Will-McKnight-604/BLDC_Motor_Control/READ_ME.txt

THE FOLDER STRUCTURE IS DIVIDED INTO:

- PROJECTS
- RESOURCES

THE PROJECTS FOLDER CONTAINS ALL THE PROJECT RELATED FILES.
THE RESOURCE FOLDER; INCLUDES ALL THE DOCUMENTATION REGARDING YOUR COMPANY FILES, SUCH AS TEMPLATES, LIBRARIES AND SO FORTH.
