Will-McKnight-604/BLDC_Motor_Control/Resources/Templates/Documentation Templates/Technical-Specification-Template.xlsx

Sheet: CORE 1. Product Vision
CORE BLOCK 1. Understanding the Product Vision and Problem-Solving Objective
Steps | Questions | Guidance | Your answers
STEP 1. Product Purpose Clarification | Can you describe the core vision behind this product? What is the primary function or experience that it is intended to deliver? | Please provide a clear and concise statement that captures the essence of the product's intent. This should reflect the unique value proposition and the experience you envision for the user.
STEP 2. Problem Identification | What specific problem or user pain point is this product aiming to address? | Detail the challenges or gaps in the current market or user experience that your product seeks to overcome. Explain how this problem affects potential users and the difference your product will make.
STEP 3. Design Relevance | How does the intended purpose of the product align with our design principles and user needs? | Discuss how the product's purpose resonates with existing design guidelines and user requirements. Consider the relevance to the target audience and how the design will cater to their preferences and behaviors.
STEP 4. Impact Analysis | In what ways will this product change or enhance the current state of affairs or user experience? | Provide an analysis of how the product is expected to impact the user's life or the broader context it fits into. This could include potential shifts in user behavior, market trends, or technological advancements.

Sheet: CORE 2. Block Diagram
CORE BLOCK 2. Facilitating the Creation of a Block Diagram
Steps | Questions | Guidance | Your answers
STEP 1. Foundation Setting | What are the main functions that the product must perform? List them out. | Start by identifying the primary functions the product will serve. These functions will form the main blocks of your diagram, setting the foundation for the overall structure.
STEP 2. Sub-Function Exploration | Within each main function, what are the essential sub-functions or components required? | Break down each main function into its necessary sub-functions. These will become the smaller blocks within your main functional blocks, helping to detail the inner workings of the product.
STEP 3. Interconnection Mapping | How do these sub-functions interact with each other and with the main functions? | For each sub-function, identify its inputs and outputs, and determine how it connects to other parts of the system. This will help in drawing the lines and arrows that show the flow of information, energy, or materials between blocks.
STEP 4. Hierarchy Determination | Is there a hierarchy or flow that naturally forms among the blocks based on their interactions? | Determine if there is a top-down or sequential flow that should be represented in the diagram. This might indicate the process flow or the importance of certain functions within the product.
STEP 5. Refinement and Review | What adjustments can be made to simplify or clarify the diagram? Are there redundant or missing elements? | Continuously refine the diagram by removing unnecessary complexity and ensuring all critical elements are represented. Review the diagram with stakeholders to validate its accuracy and comprehensibility.
STEP 6. Tool Selection for Digitalization | Which software or online tool will you use to create the digital version of this block diagram? | Choose a digital tool like draw.io, Lucidchart, or Microsoft Visio for creating a cleaner, more shareable version of your block diagram. Consider ease of use and collaboration features in your selection.
BLOCK DIAGRAM

Sheet: CORE 3. Design Requirement
CORE BLOCK 3. Prerequisite Design Requirements
Category | Requirement | Details | Examples/Options
Environmental Conditions | Operational Temperature Range | Define the range of temperatures in which the product must operate reliably. | 0 to 50°C (Consider wider ranges for extreme environments)
 | Humidity Tolerance | Specify the range of relative humidity levels the product can withstand during operation. | 5-95% non-condensing RH (Adjust for tropical or arid climates as needed)
 | Vibration Resistance | Detail the expected vibration levels the product should withstand, including frequency and amplitude. | Compliant with ISO 16750-3 for transportation and mounted operations on vehicles
 | Shock Resistance | Outline the levels and types of shock the product should resist without malfunction. | Meets MIL-STD-810G Method 516.6 for shock resistance during transportation or when mounted on machinery
 | Impact Durability | Determine if the product is likely to be subject to impacts and the level of protection required. | N/A (Specify if needed, e.g., drop-resistant to 1 meter)
 | Installation Setting | Define the typical environment for installation, whether indoors, outdoors, or variable. | Primarily indoor with potential for outdoor use under shelter
 | Mounting Considerations | Specify the mounting options and requirements based on the installation environment. | Versatile mounting: capable of tabletop, DIN rail, wall, and pole mounting options
 | Exposure to Corrosives | Assess the likelihood of corrosive substances in the environment and required protections. | No exposure anticipated (Consider corrosion-resistant materials if yes)
 | Marine Environment Exposure | Evaluate the need for marine-grade materials and protections if used near the sea. | Not required (Marine-grade protections for coastal installations if yes)
 | Weatherproofing Needs | Identify the need for weatherproofing measures based on outdoor exposure. | Not necessary (Weatherproofing required for outdoor applications if yes)
Compliance & Certification | CE / FCC Certification | Confirm the need for international regulatory compliance. | Required for sale in the EU and USA
 | UL Listing | Determine if UL safety certification is needed for the target market. | Not needed (Specify if necessary for consumer electronics or specific industries)
 | Environmental Standard Compliance | Verify if standardized environmental testing is needed for temperature, humidity, vibration, and shock. | Compliance with IEC 60068-2 standards
 | Electrical Safety Standards | Identify the relevant electrical safety standards applicable to the product. | Not required (Specify standards like IEC 60950 if applicable)
 | Hazard Safety | Consider if the product needs to be flame retardant, explosion-proof, or have other hazard mitigations. | Not applicable (Specify UL 94 for flame retardancy or ATEX for explosion-proof environments if applicable)
 | Ingress Protection (IP) Rating | Choose the appropriate IP rating to protect against solid objects and liquids. | IP65 (Consider higher IP ratings for harsh environments)
Costing & Budget | Target BOM Cost | Establish a budget for the Bill of Materials, considering all components and manufacturing processes. | 300 CHF for the electronics board (Consider additional costs for high-durability materials or complex components)
Production Volume & Availability | Expected Production Volume | Project the manufacturing volumes to determine economies of scale and component sourcing strategies. | 100 units monthly (Adjust based on market analysis and capacity)
 | Long-Term Availability | Plan for the duration of product availability and manufacturing based on industry standards and market demand. | 3 - 4 years (Extend this for industries with longer product lifecycles)
Warranty & Reliability | Warranty Parameters | Define the warranty period and terms based on product reliability and market expectations. | 2-year full replacement warranty, 1-year warranty on manufacturing defects (Consider extended warranties for premium lines)

Sheet: CORE 4. Main Features
CORE BLOCK 4. Main Technical Specifications
Specification Category | Details | Requirement Status | Notes/Instruction to Team Member
Hardware Features | Include WiFi for wireless connectivity | Must have | Detail WiFi standards and specifications required
 | A display that is legible from at least 5 feet away | Good to have | Describe preferred display size and resolution
 | User-friendly interface with a 4×4 keypad for configuration | Must have | Provide examples of similar interfaces for reference
 | LED indicators for power status and GPRS connectivity | Must have | Specify LED colors and positions
 | Serial communication via one RS232 and two RS485 interfaces | Must have | Detail any specific protocol or pinout requirements
 | Four digital inputs that are compatible with 24V signals | Must have | Confirm electrical specifications and safety requirements
 | Two relay outputs for controlling external devices | Good to have | Define the current and voltage rating for the relays
 | Device should operate on a 5V DC power input | Must have | Ensure compatibility with standard power supplies
 | Indicative LEDs on the power supply | Good to have | Specify desired indication signals (e.g., power, status)
 | Power efficiency with no more than 5W at peak and 2W typically | Must have | Provide calculations or benchmarks for power usage
Hardware Protections | Implement overvoltage, reverse voltage, and overcurrent protection for the power supply | Yes | Outline necessary certifications or standards
 | For RS232: Include ESD protection; assess need for isolation and surge protection | No (Isolation 4KV), Yes (ESD), No (Surge 4KV) | Justify the decision for inclusion or exclusion
 | For RS485: Ensure isolation and protect against ESD and power surges | Yes | Document the isolation level and surge protection details
Firmware Specifications | Determine if PC-based configuration software is necessary, and identify the supporting operating systems | To be determined | Draft potential user scenarios and compatibility tests
 | Evaluate the need for a mobile application and specify which mobile operating systems it should support | To be determined | Propose a list of core functionalities for the app
 | Outline the firmware's code structure and flow | To be determined | Create a preliminary flow chart for firmware logic
Field Upgradable Firmware | Decide on the wireless and wired connectivity options to be used for firmware upgrades | To be determined | Suggest the most reliable and cost-effective methods
 | Develop a strategy to make firmware upgrades easy for support and field staff | To be determined | Brainstorm with the support team for practical solutions
 | Establish a fail-safe mechanism for firmware upgrades in case of power interruptions | To be determined | Research best practices and existing technologies
PC or Mobile Software | Assess the necessity for PC-based configuration software, the operating systems it will support, and installation methods | To be determined | Propose a clear, user-friendly installation process
 | Determine the mobile application requirements and supported mobile operating systems | To be determined | List key features and design a basic user interface
User Experience Requirements | List features that will enhance the user experience, especially for minimal/no touch scenarios in sensitive environments | To be determined | Consult with UX experts to identify user-centric features
Enclosure Specifications | Visualize and sketch the product design considering the number of PCBs and their interconnects | To be determined | Draft initial sketches and discuss with the design team
 | Select materials, estimate the target cost, and consider ease of manufacturing, repair, and user experience | To be determined | Provide a cost-benefit analysis of material choices
 | Create 3D models to ensure all components fit and evaluate the design for environmental, compliance, and thermal management needs | To be determined | Use CAD software for accurate modeling and simulations

Sheet: CORE 5. Productions
CORE BLOCK 5. Production
Manufacturing Considerations (DFM) | Validation & Production Testing
Material Selection: Opt for materials with ready availability to prevent supply chain issues. | Test Accessibility: Design to provide clear access to all test points and interfaces.
Component Sourcing: Favor standard components to simplify procurement and reduce costs. | Firmware Support: Include firmware features that enable efficient testing and diagnostics.
Assembly Process: Design assemblies for straightforward automation to reduce labor costs. | Automation Compatibility: Ensure design is suitable for automated test equipment.
Serviceability: Ensure the design allows for easy post-production service and maintenance. | Testing Efficiency: Design for quick test setup and execution with comprehensive coverage.
Cost-Effectiveness: Maintain a balance between quality and cost-efficiency. | Volume Production Testing: Prioritize testing time reduction in high-volume production without quality compromise.
Regulatory Compliance: Adhere to industry standards and certifications to avoid delays.
This table structures the key points of manufacturing and testing considerations in a clear and concise manner, suitable for team members to understand and act upon.

Sheet: CORE 6. Failure Management
CORE BLOCK 6. Field Failure Management
Product Return and Repair Strategy | - How can product design be optimized for durability to reduce the likelihood of failures?
 | - What efficient and customer-friendly return and repair policies can be implemented?
 | - How will the design accommodate easy troubleshooting and repairs to maintain brand reputation?
 | - What are the cost-benefit implications of establishing local versus centralized service centers?
 | - How can turnaround times for repairs be minimized to enhance customer satisfaction?
Repairability Decision | - How will the choice between repairability and replaceability influence the product's lifecycle and environmental impact?
 | - What strategies can be implemented to ensure that repair processes are cost-effective and logistically feasible?
 | - How will the components' selection and assembly method affect the ease of disassembly and repair?
 | - In what ways can the product design facilitate end-of-life recycling or refurbishment?

Sheet: CORE 7. Documentation & Support
CORE BLOCK 7. Documentation & Support
Section | Questions
Documentation Creation | - What are the key features and specifications to highlight in the datasheet?
 | - What formats (manual, video) will be most effective for user documentation?
 | - How can documentation be structured to assist customers through different stages of the product lifecycle?
 | - What are the common issues to address in the FAQs or troubleshooting guide to minimize support requests?
Support Infrastructure | - What support channels (email, phone, ticket, forum) will be available to customers?
 | - What standard Service Level Agreements (SLAs) will be established to manage customer expectations?
 | - How will support requests be systematically reviewed to drive product, documentation, and support improvements?
 | - Will there be an online form or system for Return Merchandise Authorization (RMA) and how will it function?
