Will-McKnight-604/BLDC_Motor_Control/Projects/Fresu/BLDC Motor Controller/Design/rev01/rev01_1/BLDC_Motor Controller/SMT PACKAGE/BOM_REV01_1.xlsx

Designator | Footprint | Quantity | Manufacturer Part Number | JLCPCB Part Number | Comment | Supplier 1 | Supplier 2 | Supplier 3 | Price Total | Substitute 1 | Substitute 2
C10, C11, C14, C17, C19, C21, C22, C54, C55, C56, C57, C8, C9 | 0603 (Imperial) | 16 | CC0603KRX7R6BB104 | C519438 | 100nF 0603 10V ±10% | LCSC (https://www.lcsc.com/product-detail/Multilayer-Ceramic-Capacitors-MLCC-SMD-SMT_YAGEO-CC0603KRX7R6BB104_C519438.html)
C12, C13 | 0603 (Imperial) | 2 | 06035A100KAT2A | C597129 | 10pF 0603 50V ±10% | LCSC (https://www.lcsc.com/product-detail/Multilayer-Ceramic-Capacitors-MLCC-SMD-SMT_Kyocera-AVX-06035A100KAT2A_C597129.html)
C16, C18, C23, C24, C26, C27, C30, C49 | 0603 (Imperial) | 8 | CL10A225KQ8NNNC | C71000 | 2.2uF 0603 6.3V ±10% | LCSC (https://www.lcsc.com/product-detail/Multilayer-Ceramic-Capacitors-MLCC-SMD-SMT_Samsung-Electro-Mechanics-CL10A225KQ8NNNC_C71000.html)
C20, C3, C4, C5, C6 | 0603 (Imperial) | 5 | CL10A105KP8NNNC | C26413 | 1uF 0603 10V ±10% | LCSC (https://www.lcsc.com/product-detail/Multilayer-Ceramic-Capacitors-MLCC-SMD-SMT_Samsung-Electro-Mechanics-CL10A105KP8NNNC_C26413.html)
C25 | 0603 (Imperial) | 1 | CC0603KRX7R9BB103 | C100042 | 10nF 0603 50V ±10% | LCSC (https://www.lcsc.com/product-detail/Multilayer-Ceramic-Capacitors-MLCC-SMD-SMT_YAGEO-CC0603KRX7R9BB103_C100042.html)
C28 | 0603 (Imperial) | 1 | CC0603KRX7R9BB121 | C107072 | 120pF 0603 50V ±10% | LCSC (https://www.lcsc.com/product-detail/Multilayer-Ceramic-Capacitors-MLCC-SMD-SMT_YAGEO-CC0603KRX7R9BB121_C107072.html)
C29 | 0603 (Imperial) | 1 | CC0603KRX7R0BB223 | C313105 | 22nF 0603 100V ±10% | LCSC (https://www.lcsc.com/product-detail/Multilayer-Ceramic-Capacitors-MLCC-SMD-SMT_YAGEO-CC0603KRX7R0BB223_C313105.html)
C31, C32, C34, C36, C37, C38, C40, C41, C44,C35, C39, C43, C2,C33 | 0603 (Imperial) | 10 | CL10B104KC8NNNC | C15725 | 100nF 0603 100V ±10% | LCSC (https://www.lcsc.com/product-detail/Multilayer-Ceramic-Capacitors-MLCC-SMD-SMT_Samsung-Electro-Mechanics-CL10B104KC8NNNC_C15725.html)
C45, C46 | 0603 (Imperial) | 2 | CC0603KRX7R9BB222 | C107082 | 2.2nF 50V ±10% 0603 | LCSC (https://www.lcsc.com/product-detail/Multilayer-Ceramic-Capacitors-MLCC-SMD-SMT_YAGEO-CC0603KRX7R9BB222_C107082.html)
C47, C48 | 0603 (Imperial) | 2 | CC0603JRNPO9BN510 | C107051 | 51pF 50V ±5% 0603 | LCSC (https://www.lcsc.com/product-detail/Multilayer-Ceramic-Capacitors-MLCC-SMD-SMT_YAGEO-CC0603JRNPO9BN510_C107051.html)
C50, C51, C52, C53 | 0603 (Imperial) | 4 | 0603B472K500NT | C53987 | 4.7nF 50V ±10% 0603 | LCSC (https://www.lcsc.com/product-detail/Multilayer-Ceramic-Capacitors-MLCC-SMD-SMT_FH-Guangdong-Fenghua-Advanced-Tech-0603B472K500NT_C53987.html)
C7 | 0603 (Imperial) | 1 | CL10A106MP8NNNC | C85713 | 10uF 0603 10V ±10% | LCSC (https://www.lcsc.com/product-detail/Multilayer-Ceramic-Capacitors-MLCC-SMD-SMT_Samsung-Electro-Mechanics-CL10A106MP8NNNC_C85713.html)
FB1 | 0603 (Imperial) | 1 | BLM18PG121SN1D | C14709 | 120 OHM @100MHz 0603 Ferrite Beads | LCSC (https://www.lcsc.com/product-detail/Ferrite-Beads_Murata-Electronics-BLM18PG121SN1D_C14709.html)
R1, R18, R20, R22, R28, R3, R32, R37 | 0603 (Imperial) | 8 | 0603WAF3902T5E | C23153 | 39k OHM 0603 RES ±1% | LCSC (https://www.lcsc.com/product-detail/Chip-Resistor-Surface-Mount_UNI-ROYAL-Uniroyal-Elec-0603WAF3902T5E_C23153.html)
R10, R11, R19, R2, R21, R23, R43, R44, R45 | 0603 (Imperial) | 9 | 0603WAF2201T5E | C4190 | 2.2k OHM 0603 RES ±1% | LCSC (https://www.lcsc.com/product-detail/Chip-Resistor-Surface-Mount_UNI-ROYAL-Uniroyal-Elec-0603WAF2201T5E_C4190.html)
R12 | 0603 (Imperial) | 1 | 0603WAF1602T5E | C4210 | 16k OHM 0603 RES ±1% | LCSC (https://www.lcsc.com/product-detail/Chip-Resistor-Surface-Mount_UNI-ROYAL-Uniroyal-Elec-0603WAF1602T5E_C4210.html)
R13, R42, R46, R47, R48, R49 | 0603 (Imperial) | 7 | 0603WAF1002T5E | C25804 | 10k OHM 0603 RES ±1% | LCSC (https://www.lcsc.com/product-detail/Chip-Resistor-Surface-Mount_UNI-ROYAL-Uniroyal-Elec-0603WAF1002T5E_C25804.html)
R14 | 0603 (Imperial) | 1 | FRC0603F2053TS | C5126104 | 205k OHM 0603 RES ±1% | LCSC (https://www.lcsc.com/product-detail/Chip-Resistor-Surface-Mount_FOJAN-FRC0603F2053TS_C5126104.html)
R15 | 0603 (Imperial) | 1 | 0603WAF1004T5E | C22935 | 1M OHM 0603 RES ±1% | LCSC (https://www.lcsc.com/product-detail/Chip-Resistor-Surface-Mount_UNI-ROYAL-Uniroyal-Elec-0603WAF1004T5E_C22935.html)
R16 | 0603 (Imperial) | 1 | 0603WAF1802T5E | C25810 | 18k OHM 0603 RES ±1% | LCSC (https://www.lcsc.com/product-detail/Chip-Resistor-Surface-Mount_UNI-ROYAL-Uniroyal-Elec-0603WAF1802T5E_C25810.html)
R17 | 0603 (Imperial) | 1 | 0603WAF3301T5E | C22978 | 3.3k OHM 0603 RES ±1% | LCSC (https://www.lcsc.com/product-detail/Chip-Resistor-Surface-Mount_UNI-ROYAL-Uniroyal-Elec-0603WAF3301T5E_C22978.html)
R24, R25, R30, R31, R33, R34 | 0603 (Imperial) | 6 | 0603WAF470KT5E | C23164 | 4.7 OHM 0603 RES ±1% | LCSC (https://www.lcsc.com/product-detail/Chip-Resistor-Surface-Mount_UNI-ROYAL-Uniroyal-Elec-0603WAF470KT5E_C23164.html)
R26, R27, R35, R36, R9 | 0603 (Imperial) | 5 | 0603WAF1000T5E | C22775 | 100 OHM 0603 RES ±1% | LCSC (https://www.lcsc.com/product-detail/Chip-Resistor-Surface-Mount_UNI-ROYAL-Uniroyal-Elec-0603WAF1000T5E_C22775.html)
R39 | 0603 (Imperial) | 1 | 0603WAF1200T5E | C22787 | 120 OHM 0603 RES ±1% | LCSC (https://www.lcsc.com/product-detail/Chip-Resistor-Surface-Mount_UNI-ROYAL-Uniroyal-Elec-0603WAF1200T5E_C22787.html)
R4, R62, R7, R8 | 0603 (Imperial) | 4 | 0603WAF1001T5E | C21190 | 1k OHM 0603 RES ±1% | LCSC (https://www.lcsc.com/product-detail/Chip-Resistor-Surface-Mount_UNI-ROYAL-Uniroyal-Elec-0603WAF1001T5E_C21190.html)
R40, R41 | 0603 (Imperial) | 2 | 0603WAF100JT5E | C22859 | 10 OHM 0603 RES ±1% | LCSC (https://www.lcsc.com/product-detail/Chip-Resistor-Surface-Mount_UNI-ROYAL-Uniroyal-Elec-0603WAF100JT5E_C22859.html)
R5, R50, R51, R52, R53, R54, R55, R6, R60, R61 | 0603 (Imperial) | 10 | 0603WAF0000T5E | C21189 | 0 OHM 0603 RES ±1% | LCSC (https://www.lcsc.com/product-detail/Chip-Resistor-Surface-Mount_UNI-ROYAL-Uniroyal-Elec-0603WAF0000T5E_C21189.html)
R56, R57 | 0603 (Imperial) | 2 | 0603WAF5101T5E | C23186 | 5.1k OHM 0603 RES ±1% | LCSC (https://www.lcsc.com/product-detail/Chip-Resistor-Surface-Mount_UNI-ROYAL-Uniroyal-Elec-0603WAF5101T5E_C23186.html)
R58, R59 | 0603 (Imperial) | 2 | 0603WAF220JT5E | C23345 | 22 OHM 0603 RES ±1% | LCSC (https://www.lcsc.com/product-detail/Chip-Resistor-Surface-Mount_UNI-ROYAL-Uniroyal-Elec-0603WAF220JT5E_C23345.html)
TH1 | 0603 (Imperial) | 1 | NCP18XH103F03RB | C13564 | 10k OHM 0603 NTC Thermistors | LCSC (https://www.lcsc.com/product-detail/NTC-Thermistors_Murata-Electronics-NCP18XH103F03RB_C13564.html)
D10 | 1206 (Imperial) | 1 | 15-21/R6C-FQ1R1B/2T | C93133 | Red 1206 Light Emitting Diodes | LCSC (https://www.lcsc.com/product-detail/Light-Emitting-Diodes-LED_Everlight-Elec-15-21-R6C-FQ1R1B-2T_C93133.html)
D15, D2, D4, D9 | 1206 (Imperial) | 4 | 15-21/GHC-XS1T1/2T | C131257 | Emerald 1206 Light Emitting Diodes | LCSC (https://www.lcsc.com/product-detail/Light-Emitting-Diodes-LED_Everlight-Elec-15-21-GHC-XS1T1-2T_C131257.html)
C42, C59, C60 | 1210 (Imperial) | 3 | EMK325BJ106KN-T | C92769 | 10uF 1206 16V ±10% | LCSC (https://www.lcsc.com/product-detail/Multilayer-Ceramic-Capacitors-MLCC-SMD-SMT_Taiyo-Yuden-EMK325BJ106KN-T_C92769.html)
J2 | CONN-SMD_8P-P2.50_HX25003-8AWB | 1 | HX25003-8AWB | C442367 | Conn_01x08 | LCSC (https://www.lcsc.com/product-detail/Wire-To-Board-Wire-To-Wire-Connector_HX-Zhejiang-Yueqing-Hongxing-Elec-HX25003-8AWB_C442367.html)
J8 | CONN-SMD_S4B-XH-SM4-TB-LF-SN | 1 | S4B-XH-SM4-TB(LF)(SN) | C161861 | Conn_01x04 | LCSC (https://www.lcsc.com/product-detail/Wire-To-Board-Wire-To-Wire-Connector_JST-S4B-XH-SM4-TB-LF-SN_C161861.html)
J3, J9 | CONN-SMD_S6B-XH-SM4-TB-LF-SN | 2 | C2905028 | C2905028 | 1x6P XH 1 2.5mm Male pin 6 | LCSC (https://www.lcsc.com/product-detail/Wire-To-Board-Wire-To-Wire-Connector_DEALON-XH-6PWB_C2905028.html)
U5 | CONN-SMD_XH-2PWBPZ | 1 | XH-2PWBPZ | C2687444 | XH-2PWBPZ | LCSC (https://www.lcsc.com/product-detail/Wire-To-Board-Wire-To-Wire-Connector_BOOMELE-Boom-Precision-Elec-XH-2PWBPZ_C2687444.html)
J4 | CONN-SMD_XH-3AWB | 1 | C141812 | C141812 | Conn_01x03 | LCSC (https://www.lcsc.com/product-detail/Wire-To-Board-Wire-To-Wire-Connector_BOOMELE-Boom-Precision-Elec-C141812_C141812.html)
J1 | CONN-TH_XT60PW-M | 1 | XT60PW-M | C98732 | XT60PW-M | TME (https://www.tme.eu/ch/details/xt60pw-f/dc-steckverbinder/amass/?brutto=1&currency=EUR&gad_source=1)
Y1 | CRYSTAL-SMD_L5.0-W3.2 | 1 | X50328MSB2GI | C115962 | 8MHz Crystal | LCSC (https://www.lcsc.com/product-detail/Crystals_YXC-X50328MSB2GI_C115962.html)
D11, D13, D3, D6, D8 | D_SOD-323 | 5 | LRB551V-30T1G | C62119 | BAT60A | LCSC (https://www.lcsc.com/product-detail/Schottky-Barrier-Diodes-SBD_LRC-LRB551V-30T1G_C62119.html)
D5 | D_SOD-323 | 1 | PESD3V3U1UA,115 | C403915 | PESD3V3U1UA,115 | LCSC (https://www.lcsc.com/product-detail/Electrostatic-and-Surge-Protection-TVS-ESD_Nexperia-PESD3V3U1UA-115_C403915.html)
D7 | D_SOD-323 | 1 | PTVSHC3D15VUH | C312234 | SD05-7 | LCSC (https://www.lcsc.com/product-detail/Electrostatic-and-Surge-Protection-TVS-ESD_Shanghai-Prisemi-Elec-PTVSHC3D15VUH_C312234.html)
FL1 | FILTER-SMD_4P-L9.2-W6.0-P2.54-TL | 1 | 744227S | C2651119 | CMC 51UH 1A 2LN 5.5K OHM SMD | Digikey (https://www.digikey.com/en/products/detail/w%C3%BCrth-elektronik/744227S/1638886)
U3 | HTSSOP-56-1EP_6.1x14mm_P0.5mm_EP3.61x6.35mm | 1 | DRV8302DCA | C84672 | DRV8302DCA | LCSC (https://www.lcsc.com/product-detail/Motor-Driver-ICs_Texas-Instruments-DRV8302DCA_C84672.html)
L1 | IND-SMD_L7.8-W7.8_SDR0805 | 1 | SDR0805-220ML | C139488 | 22uH FIXED IND 1.5A 110 MOHM SMD | LCSC (https://www.lcsc.com/product-detail/Power-Inductors_BOURNS-SDR0805-220ML_C139488.html)
U2 | LQFP-64_10x10mm_P0.5mm | 1 | STM32F405RGT6 | C15742 | STM32F405RGTx | LCSC (https://www.lcsc.com/product-detail/Microcontroller-Units-MCUs-MPUs-SOCs_STMicroelectronics-STM32F405RGT6_C15742.html)
Printed Circuit Board | PCB | 1 | PCB_DF_ESC_rev01_1 |  | Bare Printed Circuit Board | JLCPC (https://jlcpcb.com/) | PCBWAY (https://www.pcbway.com/) |  | $1.48
C1, C58 | Plugin, Radial D16xL25mm | 2 | LKMI2501K821MF | C443097 | 820uF 80V 32m Ohm@100kHz ±20% | LCSC (https://www.lcsc.com/product-detail/Aluminum-Electrolytic-Capacitors-Leaded_Ymin-LKMI2501K821MF_C443097.html) | Digikey -TBC (https://www.digikey.com/en/products/detail/80ZLH820MEFC18X25/1189-3060-ND/3564711?curr=usd) |  |  | 80ZLH820MEFC18X25
Q1, Q2, Q3, Q4, Q5, Q6 | PQFN-8_L6.0-W5.0-P1.27-LS6.0-BL | 6 | HSBA15810C | C845605 | 100V 100A 4.5m?@10V,30A 208W 4V@250uA N Channel PQFN-8(5x6) MOSFETs | LCSC (https://www.lcsc.com/product-detail/MOSFETs_HUASHUO-HSBA15810C_C845605.html)
R29, R38 | RES-SMD_L7.0-W6.7 | 2 | WSLP27261L000FEA | C500635 | RES 0.001 OHM 1% 7W 2726 | LCSC (https://www.lcsc.com/product-detail/Current-Sense-Resistors-Shunt-Resistors_Vishay-Intertech-WSLP27261L000FEA_C500635.html)
D1 | SMA | 1 | SMAJ60A | C707480 | SMAJ60A | LCSC (https://www.lcsc.com/product-detail/Electrostatic-and-Surge-Protection-TVS-ESD_FTR-SMAJ60A_C707480.html)
D12 | SOD-123W_L2.9-W2.1-LS4.4-RD | 1 | PMEG6020ER,115 | C98663 | PMEG6020 | LCSC (https://www.lcsc.com/product-detail/Schottky-Barrier-Diodes-SBD_Nexperia-PMEG6020ER-115_C98663.html)
U4 | SOIC-8_3.9x4.9mm_P1.27mm | 1 | SN65HVD230DR | C12084 | SN65HVD230 | LCSC (https://www.lcsc.com/product-detail/CAN-ICs_Texas-Instruments-SN65HVD230DR_C12084.html)
U1 | SOT-223 | 1 | AMS1117-3.3 | C347222 | AMS1117-3.3 | LCSC (https://www.lcsc.com/product-detail/Linear-Voltage-Regulators-LDO_UMW-Youtai-Semiconductor-Co-Ltd-AMS1117-3-3_C347222.html)
SW1 | SW-SMD_4P-L5.2-W5.2-P3.70-LS6.4 | 1 | PTS526SK15SMTR2LFS | C2689521 | SW_DIP_x01 | LCSC (https://www.lcsc.com/product-detail/Tactile-Switches_C-K-PTS526SK15SMTR2LFS_C2689521.html)
D14 | TSOT-23 | 1 | ESDCAN24-2BLY | C5158050 | ESDCAN24-2BLY | LCSC (https://www.lcsc.com/product-detail/Electrostatic-and-Surge-Protection-TVS-ESD_UMW-Youtai-Semiconductor-Co-Ltd-ESDCAN24-2BLY_C5158050.html)
J10 | USB-C_SMD-TYPE-C-31-M-12 | 1 | TYPE-C-31-M-12 | C165948 | TYPE-C-31-M-12 | LCSC (https://www.lcsc.com/product-detail/USB-Connectors_Korean-Hroparts-Elec-TYPE-C-31-M-12_C165948.html)
J5, J6, J7 | WE_7461084 | 3 | 7461084 | C6828431 | 160A TERM REDCUBE M6 8PIN PCB | Digikey (https://www.digikey.com/en/products/detail/w%C3%BCrth-elektronik/7461084/2682494)
CR1 | XSON-7_L2.2-W1.2-P0.50-BL | 1 | PUSB3AB6Z | C553550 | PUSB3AB6Z | LCSC (https://www.lcsc.com/product-detail/Electrostatic-and-Surge-Protection-TVS-ESD_Nexperia-PUSB3AB6Z_C553550.html)
 |  |  |  |  |  |  |  |  |  |  |  | S
