Will-McKnight-604/BLDC_Motor_Control/Projects/Fresu/BLDC Motor Controller/Released/rev03/rev03_1/Manufacturing Files/READ_ME.txt

ADD IN THIS FOLDERS THE GERBERS FILES, THE NC DRILL files, PICK AND PLACE FILES, ASSEMBLY FILES; AND OTHER RELEVANT FILES FOR THE FABRICATION OF THE BOARD
