Will-McKnight-604/BLDC_Motor_Control/(list of files, drawings)

Other design files:
Projects/Fresu/BLDC Motor Controller/Design/rev01/rev01_1/BLDC_Motor Controller/Imported (1) BLDC_Motor Controller/4xxx.SchLib
Projects/Fresu/BLDC Motor Controller/Design/rev01/rev01_1/BLDC_Motor Controller/Imported (1) BLDC_Motor Controller/4xxx_IEEE.SchLib
Projects/Fresu/BLDC Motor Controller/Design/rev01/rev01_1/BLDC_Motor Controller/Imported (1) BLDC_Motor Controller/74xGxx.SchLib
Projects/Fresu/BLDC Motor Controller/Design/rev01/rev01_1/BLDC_Motor Controller/Imported (1) BLDC_Motor Controller/74xx.SchLib
Projects/Fresu/BLDC Motor Controller/Design/rev01/rev01_1/BLDC_Motor Controller/Imported (1) BLDC_Motor Controller/74xx_IEEE.SchLib
Projects/Fresu/BLDC Motor Controller/Design/rev01/rev01_1/BLDC_Motor Controller/Imported (1) BLDC_Motor Controller/2024-01-13_18-17-24.SchLib
Projects/Fresu/BLDC Motor Controller/Design/rev01/rev01_1/BLDC_Motor Controller/Imported (1) BLDC_Motor Controller/2024-01-13_18-25-12.SchLib
Projects/Fresu/BLDC Motor Controller/Design/rev01/rev01_1/BLDC_Motor Controller/Imported (1) BLDC_Motor Controller/Amplifier_Audio.SchLib
Projects/Fresu/BLDC Motor Controller/Design/rev01/rev01_1/BLDC_Motor Controller/Imported (1) BLDC_Motor Controller/Amplifier_Buffer.SchLib
Projects/Fresu/BLDC Motor Controller/Design/rev01/rev01_1/BLDC_Motor Controller/Imported (1) BLDC_Motor Controller/Amplifier_Current.SchLib
Projects/Fresu/BLDC Motor Controller/Design/rev01/rev01_1/BLDC_Motor Controller/Imported (1) BLDC_Motor Controller/Amplifier_Difference.SchLib
Projects/Fresu/BLDC Motor Controller/Design/rev01/rev01_1/BLDC_Motor Controller/Imported (1) BLDC_Motor Controller/Amplifier_Instrumentation.SchLib
Projects/Fresu/BLDC Motor Controller/Design/rev01/rev01_1/BLDC_Motor Controller/Imported (1) BLDC_Motor Controller/Amplifier_Operational.SchLib
Projects/Fresu/BLDC Motor Controller/Design/rev01/rev01_1/BLDC_Motor Controller/Imported (1) BLDC_Motor Controller/Amplifier_Video.SchLib
Projects/Fresu/BLDC Motor Controller/Design/rev01/rev01_1/BLDC_Motor Controller/Imported (1) BLDC_Motor Controller/Analog.SchLib
Projects/Fresu/BLDC Motor Controller/Design/rev01/rev01_1/BLDC_Motor Controller/Imported (1) BLDC_Motor Controller/Analog_ADC.SchLib
Projects/Fresu/BLDC Motor Controller/Design/rev01/rev01_1/BLDC_Motor Controller/Imported (1) BLDC_Motor Controller/Analog_DAC.SchLib
Projects/Fresu/BLDC Motor Controller/Design/rev01/rev01_1/BLDC_Motor Controller/Imported (1) BLDC_Motor Controller/Analog_Switch.SchLib
Projects/Fresu/BLDC Motor Controller/Design/rev01/rev01_1/BLDC_Motor Controller/Imported (1) BLDC_Motor Controller/Audio.SchLib
Projects/Fresu/BLDC Motor Controller/Design/rev01/rev01_1/BLDC_Motor Controller/Imported (1) BLDC_Motor Controller/Battery_Management.SchLib
Projects/Fresu/BLDC Motor Controller/Design/rev01/rev01_1/BLDC_Motor Controller/Imported (1) BLDC_Motor Controller/BLDC_Motor Controller(1).PcbDoc
Projects/Fresu/BLDC Motor Controller/Design/rev01/rev01_1/BLDC_Motor Controller/Imported (1) BLDC_Motor Controller/BLDC_Motor Controller.PcbDoc
Projects/Fresu/BLDC Motor Controller/Design/rev01/rev01_1/BLDC_Motor Controller/Imported (1) BLDC_Motor Controller/BLDC_Motor Controller.PrjPcb
Projects/Fresu/BLDC Motor Controller/Design/rev01/rev01_1/BLDC_Motor Controller/Imported (1) BLDC_Motor Controller/BLDC_Motor Controller.SchLib
Projects/Fresu/BLDC Motor Controller/Design/rev01/rev01_1/BLDC_Motor Controller/Imported (1) BLDC_Motor Controller/Block Diagram.SchLib
Projects/Fresu/BLDC Motor Controller/Design/rev01/rev01_1/BLDC_Motor Controller/Imported (1) BLDC_Motor Controller/Buffer.SchLib
Projects/Fresu/BLDC Motor Controller/Design/rev01/rev01_1/BLDC_Motor Controller/Imported (1) BLDC_Motor Controller/CAN BUS.SchLib
Projects/Fresu/BLDC Motor Controller/Design/rev01/rev01_1/BLDC_Motor Controller/Imported (1) BLDC_Motor Controller/Comparator.SchLib
Projects/Fresu/BLDC Motor Controller/Design/rev01/rev01_1/BLDC_Motor Controller/Imported (1) BLDC_Motor Controller/Connector_Audio.SchLib
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
