Will-McKnight-604/BLDC_Motor_Control/Projects/Fresu/BLDC Motor Controller/Design/rev01/rev01_1/BLDC_Motor Controller/BLDC_Motor Controller.kicad_pcb

## KiCad design Projects/Fresu/BLDC Motor Controller/Design/rev01/rev01_1/BLDC_Motor Controller/BLDC_Motor Controller.kicad_pcb (2024-03-03)

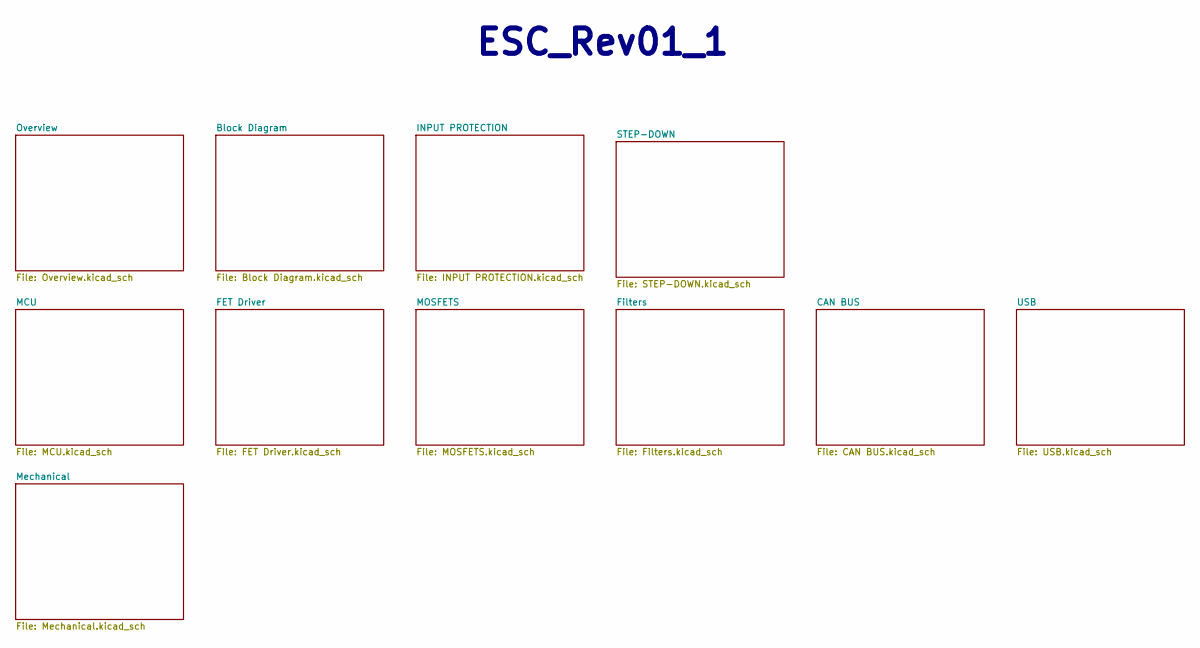
[picture p1: schematic BLDC_Motor Controller.kicad_sch, ESC_Rev01_1]

Notes on the sheet:
${TITLE}

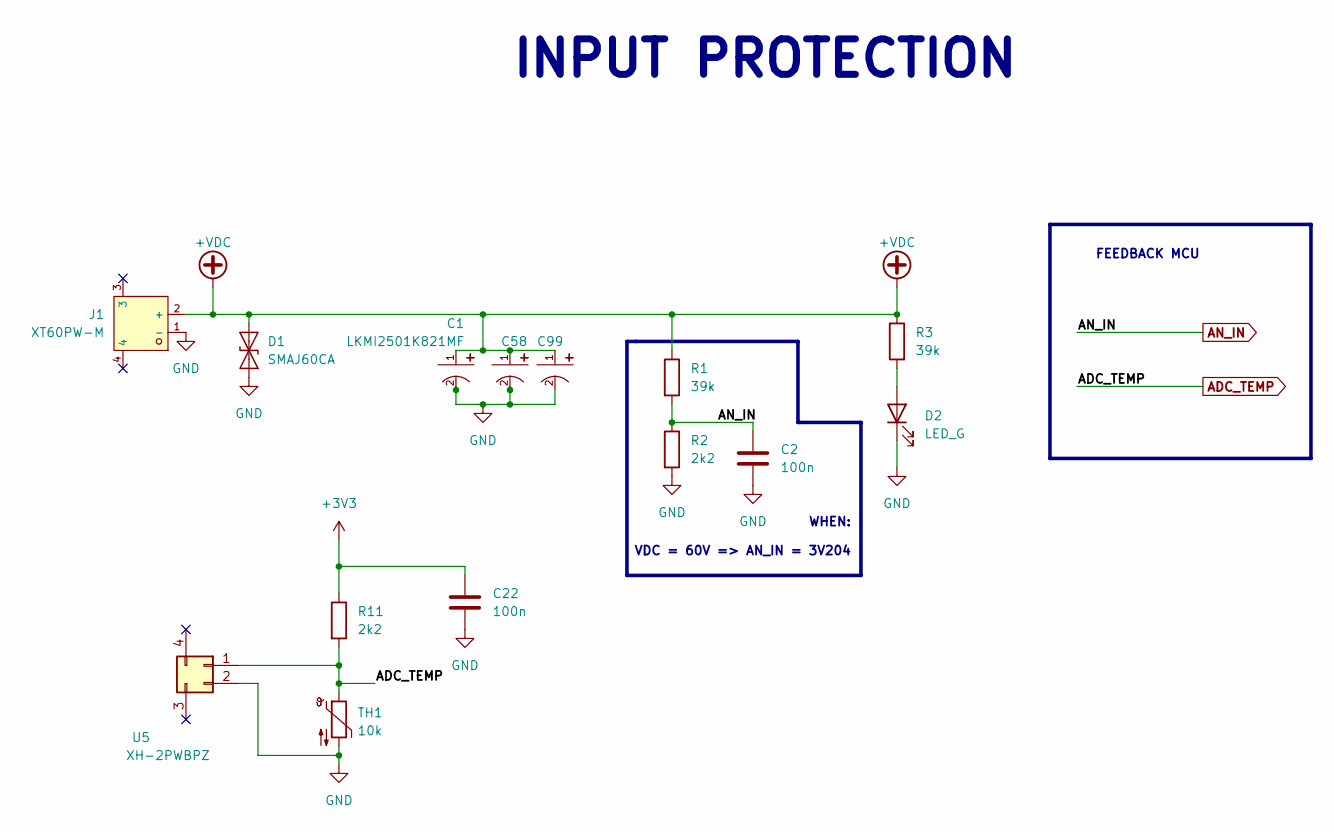
[picture p2: schematic INPUT PROTECTION.kicad_sch]

Parts:
C1, C58, C99: LKMI2501K821MF; CAP-TH_BD18.0-P7.50-D1.2-SIDE; LCSC C443097
C2, C22: 100n; C_0603_1608Metric
D1: SMAJ60CA; D_SMA
D2: LED_G; LED_1206_3216Metric
J1: XT60PW-M; CONN-TH_XT60PW-M; LCSC C98732
R1, R3: 39k; R_0603_1608Metric_Pad0.98x0.95mm_HandSolder
R2, R11: 2k2; R_0603_1608Metric_Pad0.98x0.95mm_HandSolder
TH1: 10k; R_0603_1608Metric_Pad0.98x0.95mm_HandSolder
U5: XH-2PWBPZ; CONN-SMD_XH-2PWBPZ

Connections:
+3V3: C22.1, R11.1; also elsewhere on the board
+VDC: C1.1, C58.1, C99.1, D1.2 (A2), J1.2 (+), R1.1, R3.1; also elsewhere on the board
ADC_TEMP: R11.2, TH1.1, U5.1; also elsewhere on the board
AN_IN: C2.1, R1.2, R2.1; also elsewhere on the board
GND: C1.2, C2.2, C22.2, C58.2, C99.2, D1.1 (A1), D2.1 (K), J1.1 (-), R2.2, TH1.2, U5.2; also elsewhere on the board
unnamed: D2.2 (A), R3.2

Notes on the sheet:
INPUT PROTECTION
FEEDBACK MCU
WHEN: VDC = 60V => AN_IN = 3V204

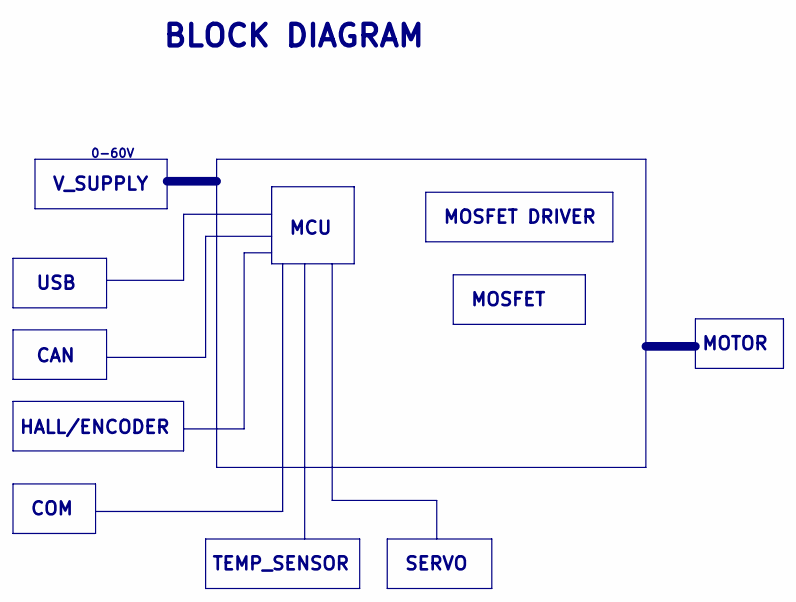
[picture p3: schematic Block Diagram.kicad_sch]

Notes on the sheet:
MCU
MOSFET
V_SUPPLY
MOTOR
TEMP_SENSOR
BLOCK DIAGRAM
USB
HALL/ENCODER
SERVO
COM
0-60V
MOSFET DRIVER
CAN

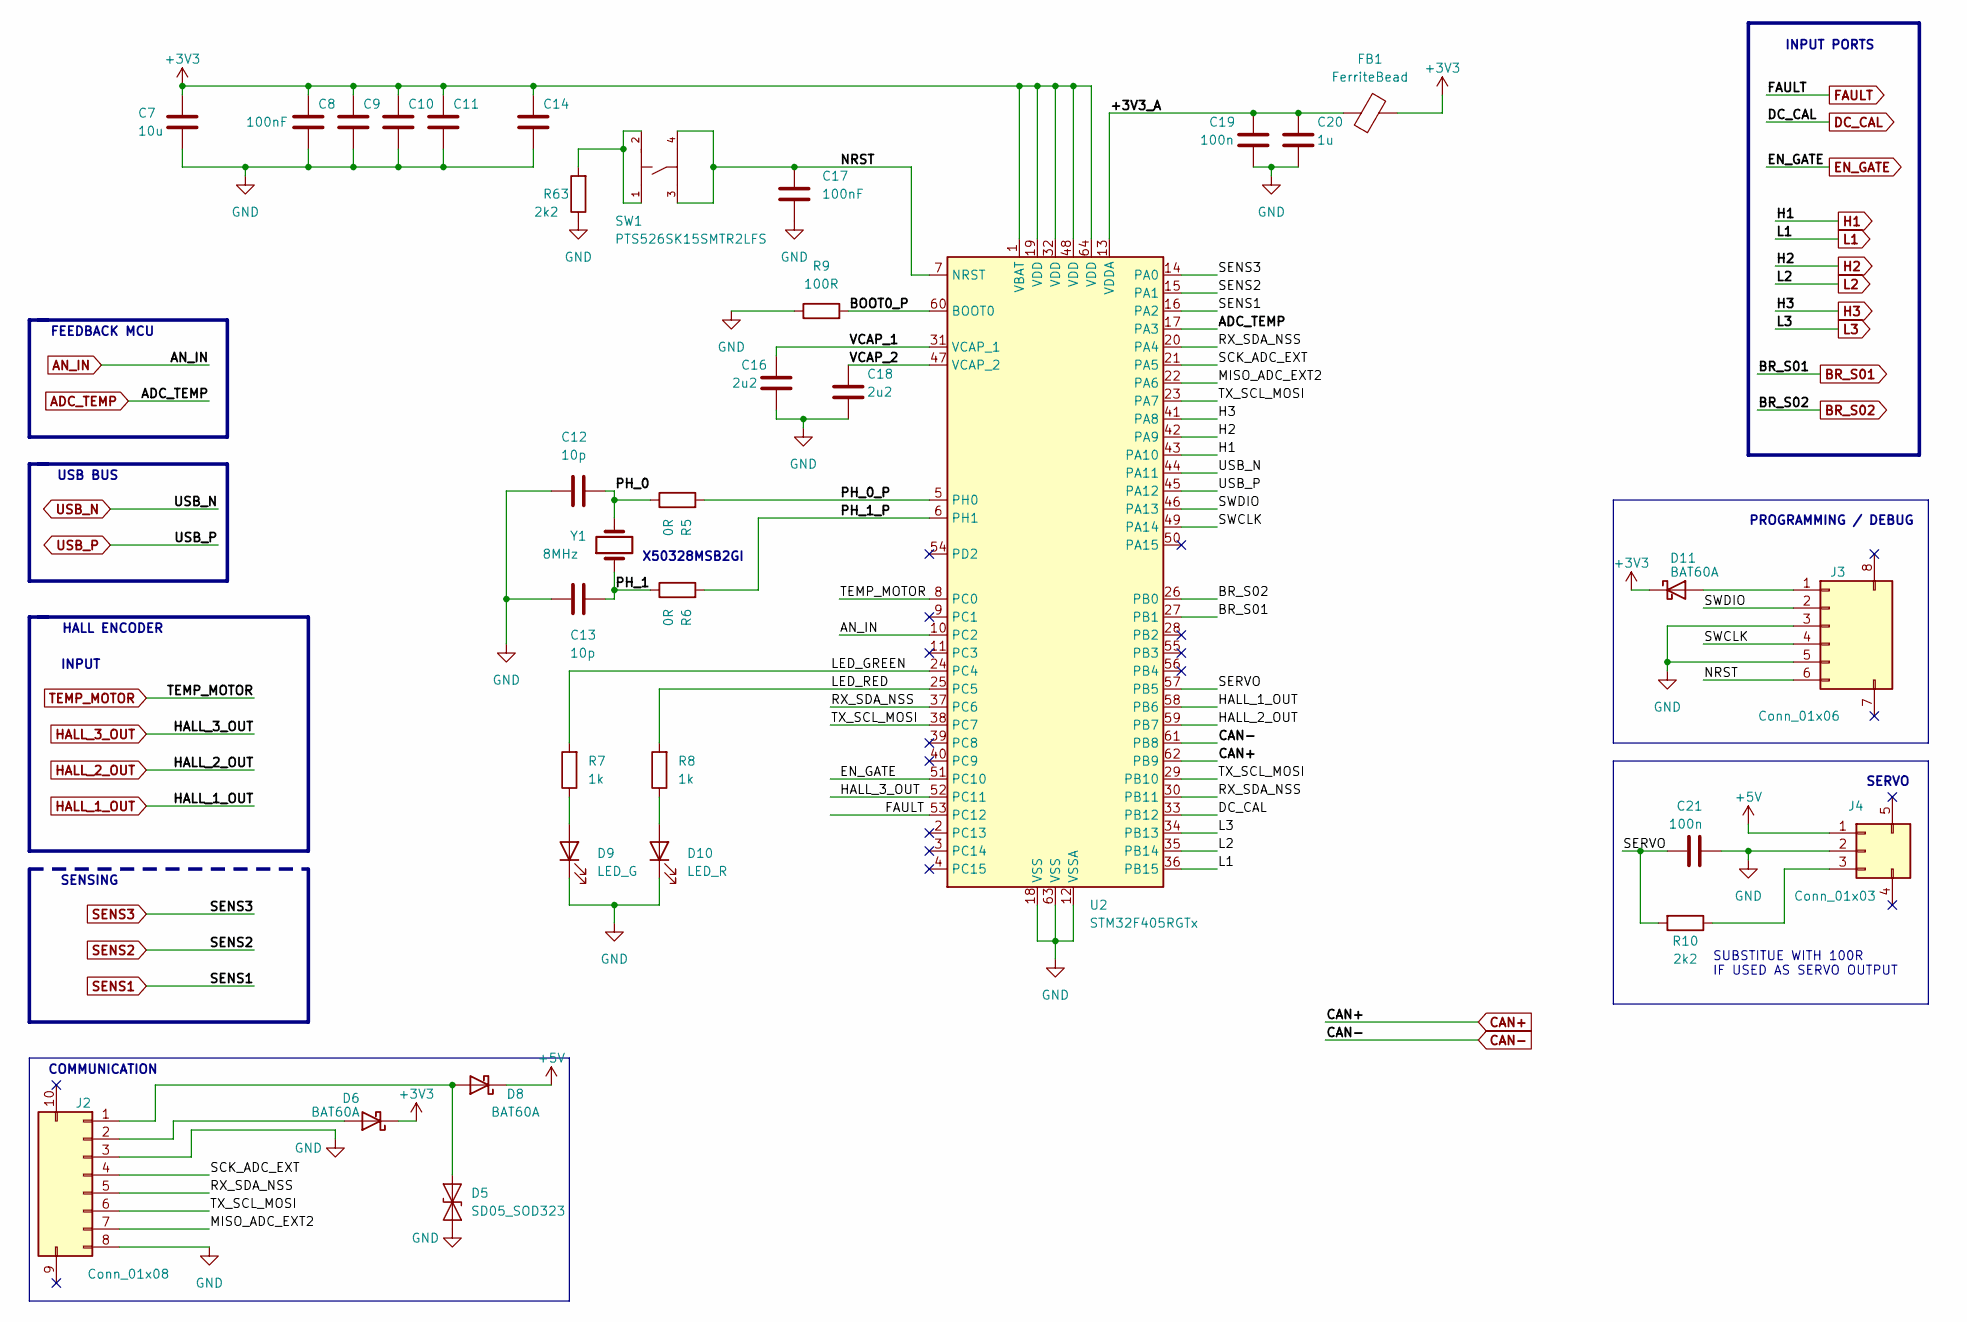
[picture p4: schematic MCU.kicad_sch]

Parts:
C7: 10u; C_0603_1608Metric
C8, C9, C10, C11, C14, C17: 100nF; C_0603_1608Metric
C12, C13: 10p; C_0603_1608Metric
C16, C18: 2u2; C_0603_1608Metric
C19, C21: 100n; C_0603_1608Metric
C20: 1u; C_0603_1608Metric
D5: SD05_SOD323; D_SOD-323
D6, D8, D11: BAT60A; D_SOD-323
D9: LED_G; LED_1206_3216Metric
D10: LED_R; LED_1206_3216Metric
FB1: FerriteBead; L_0603_1608Metric_Pad1.05x0.95mm_HandSolder
J2: Conn_01x08; CONN-SMD_8P-P2.50_HX25003-8AWB
J3: Conn_01x06; CONN-SMD_S6B-XH-SM4-TB-LF-SN
J4: Conn_01x03; CONN-SMD_XH-3AWB
R5, R6: 0R; R_0603_1608Metric_Pad0.98x0.95mm_HandSolder
R7, R8: 1k; R_0603_1608Metric_Pad0.98x0.95mm_HandSolder
R9: 100R; R_0603_1608Metric_Pad0.98x0.95mm_HandSolder
R10, R63: 2k2; R_0603_1608Metric_Pad0.98x0.95mm_HandSolder
SW1: PTS526SK15SMTR2LFS; SW-SMD_4P-L5.2-W5.2-P3.70-LS6.4; LCSC C2689521
U2: STM32F405RGTx; LQFP-64_10x10mm_P0.5mm
Y1: 8MHz; CRYSTAL-SMD_L5.0-W3.2

Connections:
+3V3: C7.1, C8.1, C9.1, C10.1, C11.1, C14.1, D6.1 (K), D11.1 (K), FB1.2, U2.1 (VBAT), U2.19 (VDD), U2.32 (VDD), U2.48 (VDD), U2.64 (VDD); also elsewhere on the board
+5V: D8.1 (K), J4.1; also elsewhere on the board
/MCU/+3V3_A: C19.1, C20.1, FB1.1, U2.13 (VDDA)
/MCU/BOOT0_P: R9.2, U2.60 (BOOT0)
/MCU/LED_GREEN: R7.2, U2.24 (PC4)
/MCU/LED_RED: R8.2, U2.25 (PC5)
/MCU/MISO_ADC_EXT2: J2.7, U2.22 (PA6)
/MCU/NRST: C17.1, J3.6, SW1.3, SW1.4, U2.7 (NRST)
/MCU/PH_0: C12.1, R5.1, Y1.2
/MCU/PH_0_P: R5.2, U2.5 (PH0)
/MCU/PH_1: C13.1, R6.1, Y1.1
/MCU/PH_1_P: R6.2, U2.6 (PH1)
/MCU/RX_SDA_NSS: J2.5, U2.20 (PA4), U2.30 (PB11), U2.37 (PC6)
/MCU/SCK_ADC_EXT: J2.4, U2.21 (PA5)
/MCU/SERVO: C21.1, R10.2, U2.57 (PB5)
/MCU/SWCLK: J3.4, U2.49 (PA14)
/MCU/SWDIO: J3.2, U2.46 (PA13)
/MCU/TX_SCL_MOSI: J2.6, U2.23 (PA7), U2.29 (PB10), U2.38 (PC7)
/MCU/VCAP_1: C16.1, U2.31 (VCAP_1)
/MCU/VCAP_2: C18.1, U2.47 (VCAP_2)
ADC_TEMP: U2.17 (PA3); also elsewhere on the board
AN_IN: U2.10 (PC2); also elsewhere on the board
BR_S01: U2.27 (PB1); also elsewhere on the board
BR_S02: U2.26 (PB0); also elsewhere on the board
CAN+: U2.62 (PB9); also elsewhere on the board
CAN-: U2.61 (PB8); also elsewhere on the board
DC_CAL: U2.33 (PB12); also elsewhere on the board
EN_GATE: U2.51 (PC10); also elsewhere on the board
FAULT: U2.53 (PC12); also elsewhere on the board
GND: C7.2, C8.2, C9.2, C10.2, C11.2, C12.2, C13.2, C14.2, C16.2, C17.2, C18.2, C19.2, C20.2, C21.2, D5.1 (A1), D9.1 (K), D10.1 (K), J2.3, J2.8, J3.3, J3.5, J4.2, R9.1, R63.1, U2.12 (VSSA), U2.18 (VSS), U2.63 (VSS); also elsewhere on the board
H1: U2.43 (PA10); also elsewhere on the board
H2: U2.42 (PA9); also elsewhere on the board
H3: U2.41 (PA8); also elsewhere on the board
HALL_1_OUT: U2.58 (PB6); also elsewhere on the board
HALL_2_OUT: U2.59 (PB7); also elsewhere on the board
HALL_3_OUT: U2.52 (PC11); also elsewhere on the board
L1: U2.36 (PB15); also elsewhere on the board
L2: U2.35 (PB14); also elsewhere on the board
L3: U2.34 (PB13); also elsewhere on the board
unnamed: D5.2 (A2), D8.2 (A), J2.1
unnamed: D6.2 (A), J2.2
unnamed: D9.2 (A), R7.1
unnamed: D10.2 (A), R8.1
unnamed: D11.2 (A), J3.1
unnamed: J4.3, R10.1
unnamed: R63.2, SW1.1, SW1.2
SENS1: U2.16 (PA2); also elsewhere on the board
SENS2: U2.15 (PA1); also elsewhere on the board
SENS3: U2.14 (PA0); also elsewhere on the board
TEMP_MOTOR: U2.8 (PC0); also elsewhere on the board
USB_N: U2.44 (PA11); also elsewhere on the board
USB_P: U2.45 (PA12); also elsewhere on the board

Notes on the sheet:
SERVO
INPUT PORTS
USB BUS
HALL ENCODER
X50328MSB2GI
INPUT
COMMUNICATION
FEEDBACK MCU
SUBSTITUE WITH 100R IF USED AS SERVO OUTPUT
SENSING
PROGRAMMING / DEBUG

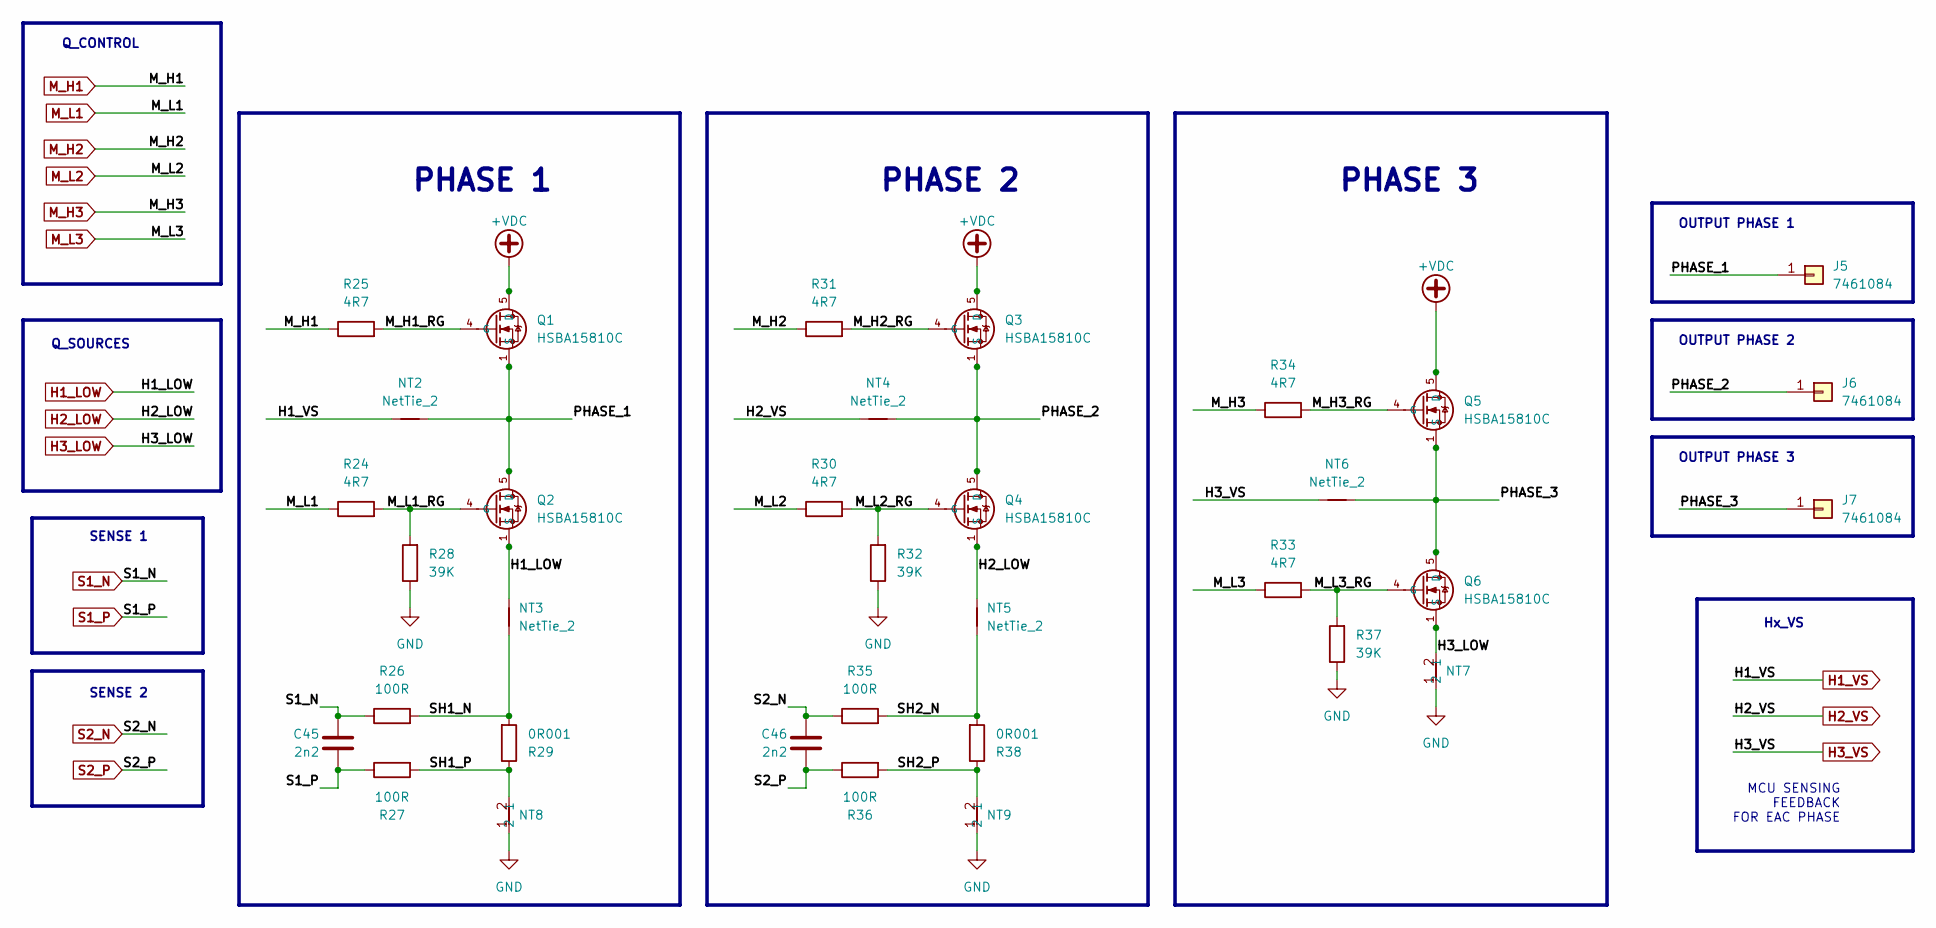
[picture p5: schematic MOSFETS.kicad_sch]

Parts:
C45, C46: 2n2; C_0603_1608Metric
J5, J6, J7: 7461084; WE_7461084
NT2, NT4, NT6: NetTie_2; NetTie-2_SMD_Pad0.5mm
NT3, NT5: NetTie_2; NetTie_SMD_Pad_3.00mm
NT7, NT8, NT9: Net_Tie_PWR; NetTie_SMD_Pad_6.00mm
Q1, Q2, Q3, Q4, Q5, Q6: HSBA15810C; PQFN-8_L6.0-W5.0-P1.27-LS6.0-BL; LCSC C845605
R24, R25, R30, R31, R33, R34: 4R7; R_0603_1608Metric_Pad0.98x0.95mm_HandSolder
R26, R27, R35, R36: 100R; R_0603_1608Metric_Pad0.98x0.95mm_HandSolder
R28, R32, R37: 39K; R_0603_1608Metric_Pad0.98x0.95mm_HandSolder
R29, R38: 0R001; RES-SMD_L7.0-W6.7

Connections:
+VDC: Q1.5 (D), Q1.6 (D), Q1.7 (D), Q1.8 (D), Q1.9 (D), Q3.5 (D), Q3.6 (D), Q3.7 (D), Q3.8 (D), Q3.9 (D), Q5.5 (D), Q5.6 (D), Q5.7 (D), Q5.8 (D), Q5.9 (D); also elsewhere on the board
/MOSFETS/M_H1_RG: Q1.4 (G), R25.2
/MOSFETS/M_H2_RG: Q3.4 (G), R31.2
/MOSFETS/M_H3_RG: Q5.4 (G), R34.2
/MOSFETS/M_L1_RG: Q2.4 (G), R24.2, R28.2
/MOSFETS/M_L2_RG: Q4.4 (G), R30.2, R32.2
/MOSFETS/M_L3_RG: Q6.4 (G), R33.2, R37.2
/MOSFETS/PHASE_1: J5.1, NT2.2, Q1.1 (S), Q1.2 (S), Q1.3 (S), Q2.5 (D), Q2.6 (D), Q2.7 (D), Q2.8 (D), Q2.9 (D)
/MOSFETS/PHASE_2: J6.1, NT4.2, Q3.1 (S), Q3.2 (S), Q3.3 (S), Q4.5 (D), Q4.6 (D), Q4.7 (D), Q4.8 (D), Q4.9 (D)
/MOSFETS/PHASE_3: J7.1, NT6.2, Q5.1 (S), Q5.2 (S), Q5.3 (S), Q6.5 (D), Q6.6 (D), Q6.7 (D), Q6.8 (D), Q6.9 (D)
/MOSFETS/SH1_N: NT3.1, R26.2, R29.2
/MOSFETS/SH1_P: NT8.2, R27.2, R29.1
/MOSFETS/SH2_N: NT5.1, R35.2, R38.2
/MOSFETS/SH2_P: NT9.2, R36.2, R38.1
GND: NT7.1, NT8.1, NT9.1, R28.1, R32.1, R37.1; also elsewhere on the board
H1_LOW: NT3.2, Q2.1 (S), Q2.2 (S), Q2.3 (S); also elsewhere on the board
H1_VS: NT2.1; also elsewhere on the board
H2_LOW: NT5.2, Q4.1 (S), Q4.2 (S), Q4.3 (S); also elsewhere on the board
H2_VS: NT4.1; also elsewhere on the board
H3_LOW: NT7.2, Q6.1 (S), Q6.2 (S), Q6.3 (S); also elsewhere on the board
H3_VS: NT6.1; also elsewhere on the board
M_H1: R25.1; also elsewhere on the board
M_H2: R31.1; also elsewhere on the board
M_H3: R34.1; also elsewhere on the board
M_L1: R24.1; also elsewhere on the board
M_L2: R30.1; also elsewhere on the board
M_L3: R33.1; also elsewhere on the board
S1_N: C45.1, R26.1; also elsewhere on the board
S1_P: C45.2, R27.1; also elsewhere on the board
S2_N: C46.1, R35.1; also elsewhere on the board
S2_P: C46.2, R36.1; also elsewhere on the board

Notes on the sheet:
OUTPUT PHASE 1
Q_SOURCES
PHASE 1
PHASE 2
OUTPUT PHASE 3
Hx_VS
SENSE 1
Q_CONTROL
SENSE 2
OUTPUT PHASE 2
MCU SENSING FEEDBACK FOR EAC PHASE
PHASE 3

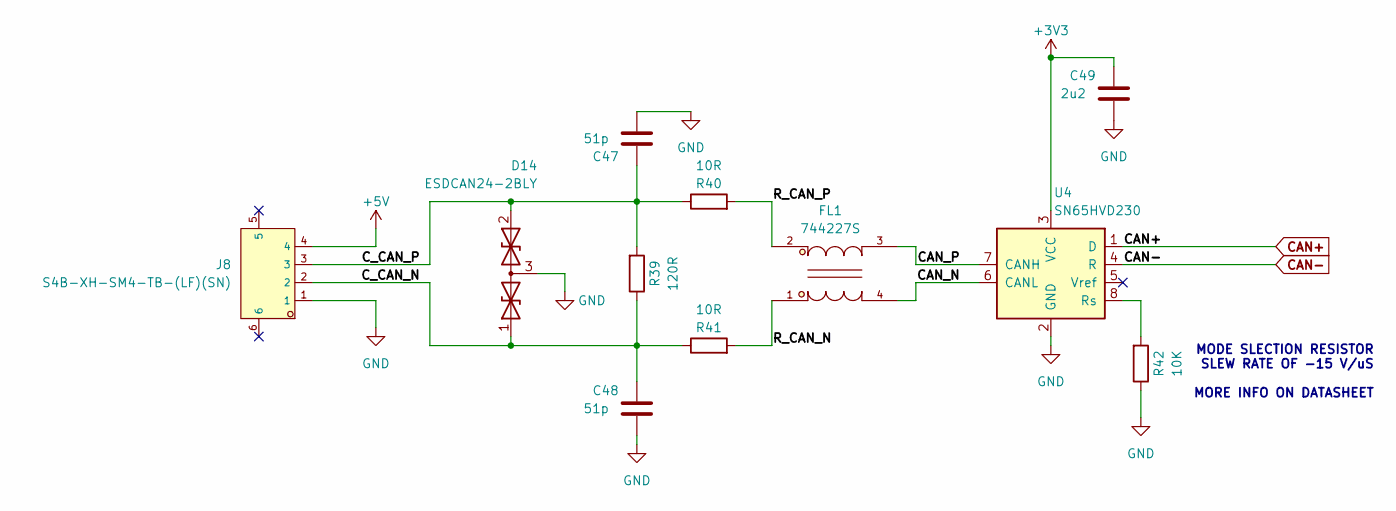
[picture p6: schematic CAN BUS.kicad_sch]

Parts:
C47, C48: 51p; C_0603_1608Metric
C49: 2u2; C_0603_1608Metric
D14: ESDCAN24-2BLY; TSOT-23
FL1: 744227S; FILTER-SMD_4P-L9.2-W6.0-P2.54-TL; LCSC C2651119
J8: S4B-XH-SM4-TB-(LF)(SN); CONN-SMD_S4B-XH-SM4-TB-LF-SN; LCSC C161861
R39: 120R; R_0603_1608Metric_Pad0.98x0.95mm_HandSolder
R40, R41: 10R; R_0603_1608Metric_Pad0.98x0.95mm_HandSolder
R42: 10K; R_0603_1608Metric_Pad0.98x0.95mm_HandSolder
U4: SN65HVD230; SOIC-8_3.9x4.9mm_P1.27mm

Connections:
+3V3: C49.1, U4.3 (VCC); also elsewhere on the board
+5V: J8.4; also elsewhere on the board
/CAN BUS/CAN_N: FL1.4, U4.6 (CANL)
/CAN BUS/CAN_P: FL1.3, U4.7 (CANH)
/CAN BUS/C_CAN_N: C48.1, D14.1 (A1), J8.2, R39.1, R41.1
/CAN BUS/C_CAN_P: C47.1, D14.2 (A2), J8.3, R39.2, R40.1
/CAN BUS/R_CAN_N: FL1.1, R41.2
/CAN BUS/R_CAN_P: FL1.2, R40.2
CAN+: U4.1 (D); also elsewhere on the board
CAN-: U4.4 (R); also elsewhere on the board
GND: C47.2, C48.2, C49.2, D14.3 (common), J8.1, R42.1, U4.2 (GND); also elsewhere on the board
unnamed: R42.2, U4.8 (Rs)

Notes on the sheet:
MODE SLECTION RESISTOR SLEW RATE OF -15 V/uS MORE INFO ON DATASHEET

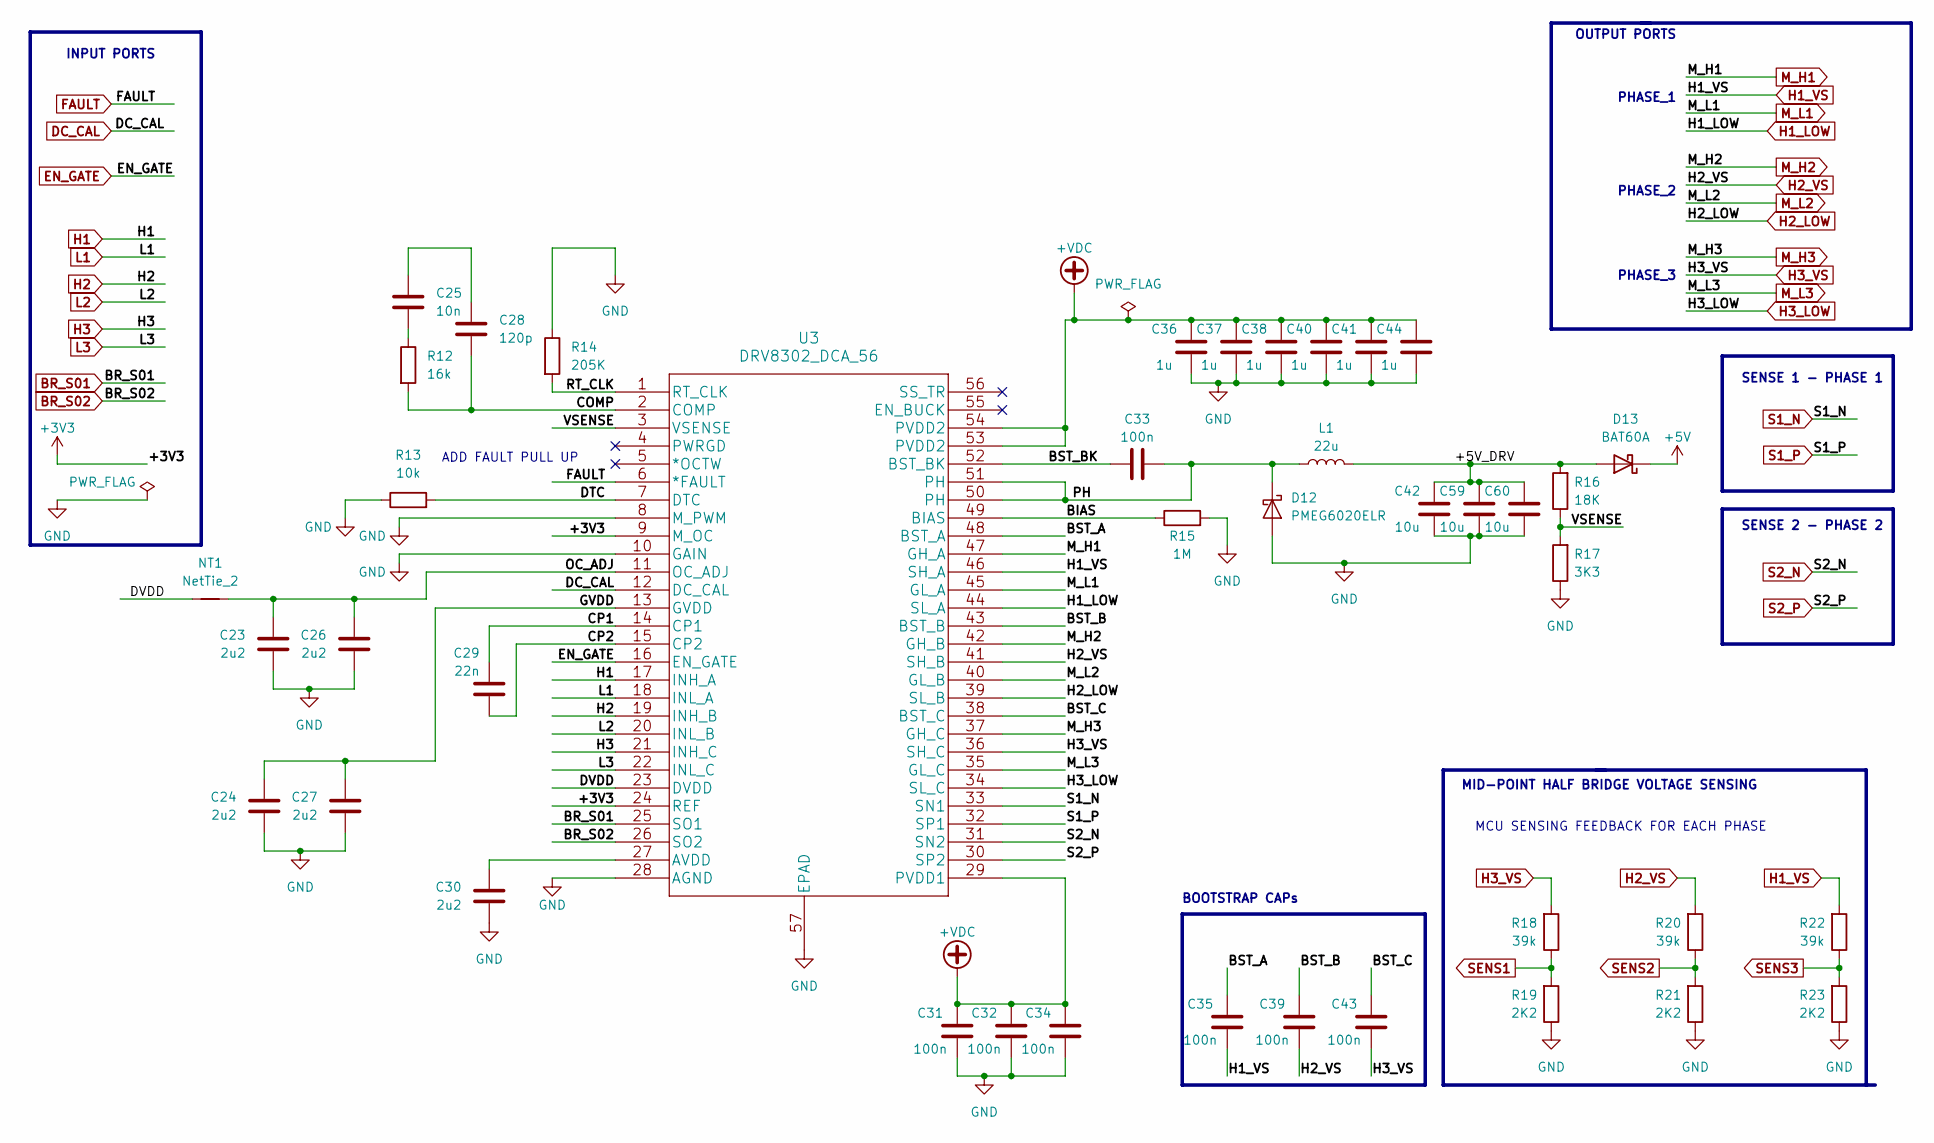
[picture p7: schematic FET Driver.kicad_sch]

Parts:
C23, C24, C26, C27, C30: 2u2; C_0603_1608Metric
C25: 10n; C_0603_1608Metric
C28: 120p; C_0603_1608Metric
C29: 22n; C_0603_1608Metric
C31, C32, C33, C34, C35, C39, C43: 100n; C_0603_1608Metric
C36, C37, C38, C40, C41, C44: 1u; C_0603_1608Metric
C42, C59, C60: 10u; C_1206_3216Metric
D12: PMEG6020ELR; Nexperia_CFP3_SOD-123W
D13: BAT60A; D_SOD-323
L1: 22u; IND-SMD_L7.8-W7.8_SDR0805
NT1: NetTie_2; NetTie_SMD_Pad_0.2mm
R12: 16k; R_0603_1608Metric_Pad0.98x0.95mm_HandSolder
R13: 10k; R_0603_1608Metric_Pad0.98x0.95mm_HandSolder
R14: 205K; R_0603_1608Metric_Pad0.98x0.95mm_HandSolder
R15: 1M; R_0603_1608Metric_Pad0.98x0.95mm_HandSolder
R16: 18K; R_0603_1608Metric_Pad0.98x0.95mm_HandSolder
R17: 3K3; R_0603_1608Metric_Pad0.98x0.95mm_HandSolder
R18, R20, R22: 39k; R_0603_1608Metric_Pad0.98x0.95mm_HandSolder
R19, R21, R23: 2K2; R_0603_1608Metric_Pad0.98x0.95mm_HandSolder
U3: DRV8302_DCA_56; HTSSOP-56-1EP_6.1x14mm_P0.5mm_EP3.61x6.35mm

Connections:
+3V3: U3.9 (M_OC), U3.24 (REF); also elsewhere on the board
+5V: D13.1 (K); also elsewhere on the board
+VDC: C31.2, C32.2, C34.2, C36.2, C37.2, C38.2, C40.2, C41.2, C44.2, U3.29 (PVDD1), U3.53 (PVDD2), U3.54 (PVDD2); also elsewhere on the board
/FET Driver/+5V_DRV: C42.2, C59.2, C60.2, D13.2 (A), L1.2, R16.2
/FET Driver/BIAS: R15.1, U3.49 (BIAS)
/FET Driver/BST_A: C35.2, U3.48 (BST_A)
/FET Driver/BST_B: C39.2, U3.43 (BST_B)
/FET Driver/BST_BK: C33.1, U3.52 (BST_BK)
/FET Driver/BST_C: C43.2, U3.38 (BST_C)
/FET Driver/COMP: C28.2, R12.2, U3.2 (COMP)
/FET Driver/CP1: C29.2, U3.14 (CP1)
/FET Driver/CP2: C29.1, U3.15 (CP2)
/FET Driver/DTC: R13.2, U3.7 (DTC)
/FET Driver/DVDD: NT1.1, U3.23 (DVDD)
/FET Driver/GVDD: C24.2, C27.2, U3.13 (GVDD)
/FET Driver/OC_ADJ: C23.2, C26.2, NT1.2, U3.11 (OC_ADJ)
/FET Driver/PH: C33.2, D12.1 (K), L1.1, U3.50 (PH), U3.51 (PH)
/FET Driver/RT_CLK: R14.2, U3.1 (RT_CLK)
/FET Driver/VSENSE: R16.1, R17.2, U3.3 (VSENSE)
BR_S01: U3.25 (SO1); also elsewhere on the board
BR_S02: U3.26 (SO2); also elsewhere on the board
DC_CAL: U3.12 (DC_CAL); also elsewhere on the board
EN_GATE: U3.16 (EN_GATE); also elsewhere on the board
FAULT: U3.6 (*FAULT); also elsewhere on the board
GND: C23.1, C24.1, C26.1, C27.1, C30.1, C31.1, C32.1, C34.1, C36.1, C37.1, C38.1, C40.1, C41.1, C42.1, C44.1, C59.1, C60.1, D12.2 (A), R13.1, R14.1, R15.2, R17.1, R19.1, R21.1, R23.1, U3.8 (M_PWM), U3.10 (GAIN), U3.28 (AGND), U3.57 (EPAD); also elsewhere on the board
H1: U3.17 (INH_A); also elsewhere on the board
H1_LOW: U3.44 (SL_A); also elsewhere on the board
H1_VS: C35.1, R22.2, U3.46 (SH_A); also elsewhere on the board
H2: U3.19 (INH_B); also elsewhere on the board
H2_LOW: U3.39 (SL_B); also elsewhere on the board
H2_VS: C39.1, R20.2, U3.41 (SH_B); also elsewhere on the board
H3: U3.21 (INH_C); also elsewhere on the board
H3_LOW: U3.34 (SL_C); also elsewhere on the board
H3_VS: C43.1, R18.2, U3.36 (SH_C); also elsewhere on the board
L1: U3.18 (INL_A); also elsewhere on the board
L2: U3.20 (INL_B); also elsewhere on the board
L3: U3.22 (INL_C); also elsewhere on the board
M_H1: U3.47 (GH_A); also elsewhere on the board
M_H2: U3.42 (GH_B); also elsewhere on the board
M_H3: U3.37 (GH_C); also elsewhere on the board
M_L1: U3.45 (GL_A); also elsewhere on the board
M_L2: U3.40 (GL_B); also elsewhere on the board
M_L3: U3.35 (GL_C); also elsewhere on the board
unnamed: C25.1, C28.1
unnamed: C25.2, R12.1
unnamed: C30.2, U3.27 (AVDD)
S1_N: U3.33 (SN1); also elsewhere on the board
S1_P: U3.32 (SP1); also elsewhere on the board
S2_N: U3.31 (SN2); also elsewhere on the board
S2_P: U3.30 (SP2); also elsewhere on the board
SENS1: R18.1, R19.2; also elsewhere on the board
SENS2: R20.1, R21.2; also elsewhere on the board
SENS3: R22.1, R23.2; also elsewhere on the board

Notes on the sheet:
PHASE_2
BOOTSTRAP CAPs
INPUT PORTS
OUTPUT PORTS
MID-POINT HALF BRIDGE VOLTAGE SENSING
MCU SENSING FEEDBACK FOR EACH PHASE
PHASE_3
PHASE_1
SENSE 2 - PHASE 2
ADD FAULT PULL UP
SENSE 1 - PHASE 1

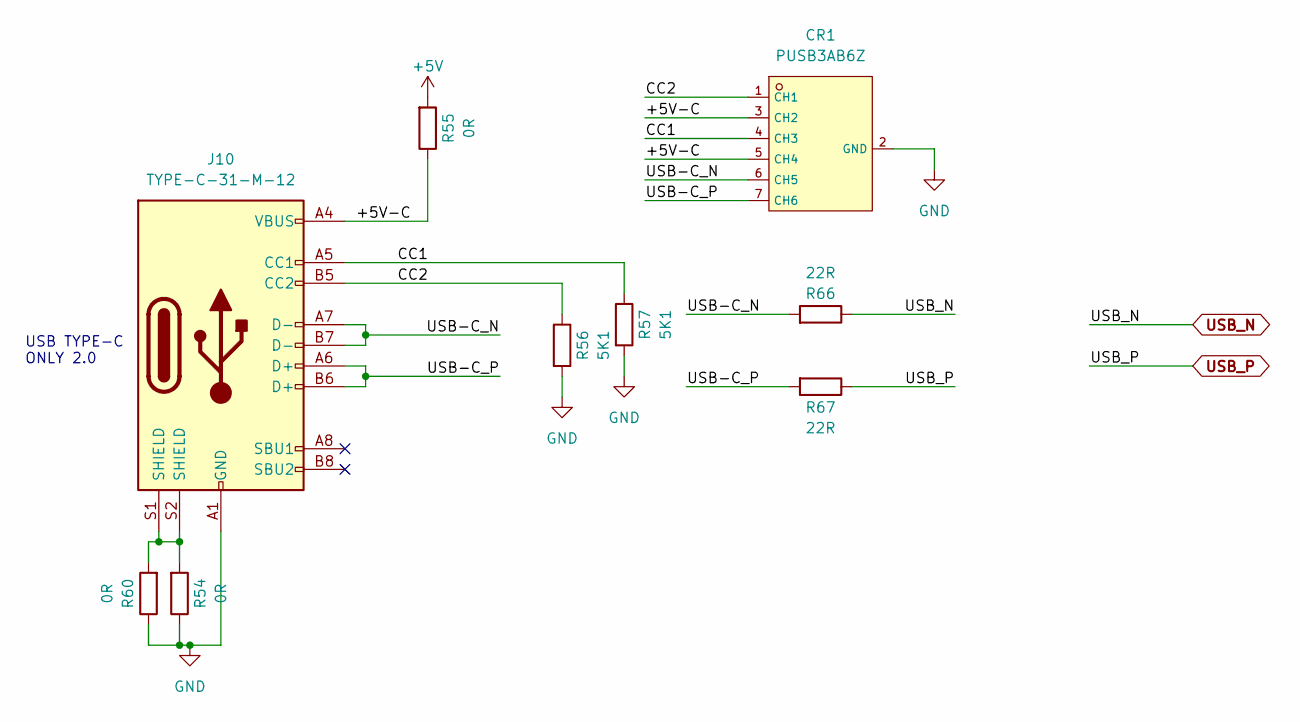
[picture p8: schematic USB.kicad_sch]

Parts:
CR1: PUSB3AB6Z; XSON-7_L2.2-W1.2-P0.50-BL; LCSC C553550
J10: TYPE-C-31-M-12; USB-C_SMD-TYPE-C-31-M-12
R54, R55, R60: 0R; R_0603_1608Metric_Pad0.98x0.95mm_HandSolder
R56, R57: 5K1; R_0603_1608Metric_Pad0.98x0.95mm_HandSolder
R66, R67: 22R; R_0603_1608Metric_Pad0.98x0.95mm_HandSolder

Connections:
+5V: R55.2; also elsewhere on the board
/USB/+5V-C: CR1.3 (CH2), CR1.5 (CH4), J10.A4 (VBUS), J10.A9 (VBUS), J10.B4 (VBUS), J10.B9 (VBUS), R55.1
/USB/CC1: CR1.4 (CH3), J10.A5 (CC1), R57.1
/USB/CC2: CR1.1 (CH1), J10.B5 (CC2), R56.1
/USB/USB-C_N: CR1.6 (CH5), J10.A7 (D-), J10.B7 (D-), R66.2
/USB/USB-C_P: CR1.7 (CH6), J10.A6 (D+), J10.B6 (D+), R67.2
GND: CR1.2 (GND), J10.A1 (GND), J10.A12 (GND), J10.B1 (GND), J10.B12 (GND), R54.1, R56.2, R57.2, R60.1; also elsewhere on the board
unnamed: J10.S1 (SHIELD), J10.S2 (SHIELD), R54.2, R60.2
USB_N: R66.1; also elsewhere on the board
USB_P: R67.1; also elsewhere on the board

Notes on the sheet:
USB TYPE-C ONLY 2.0

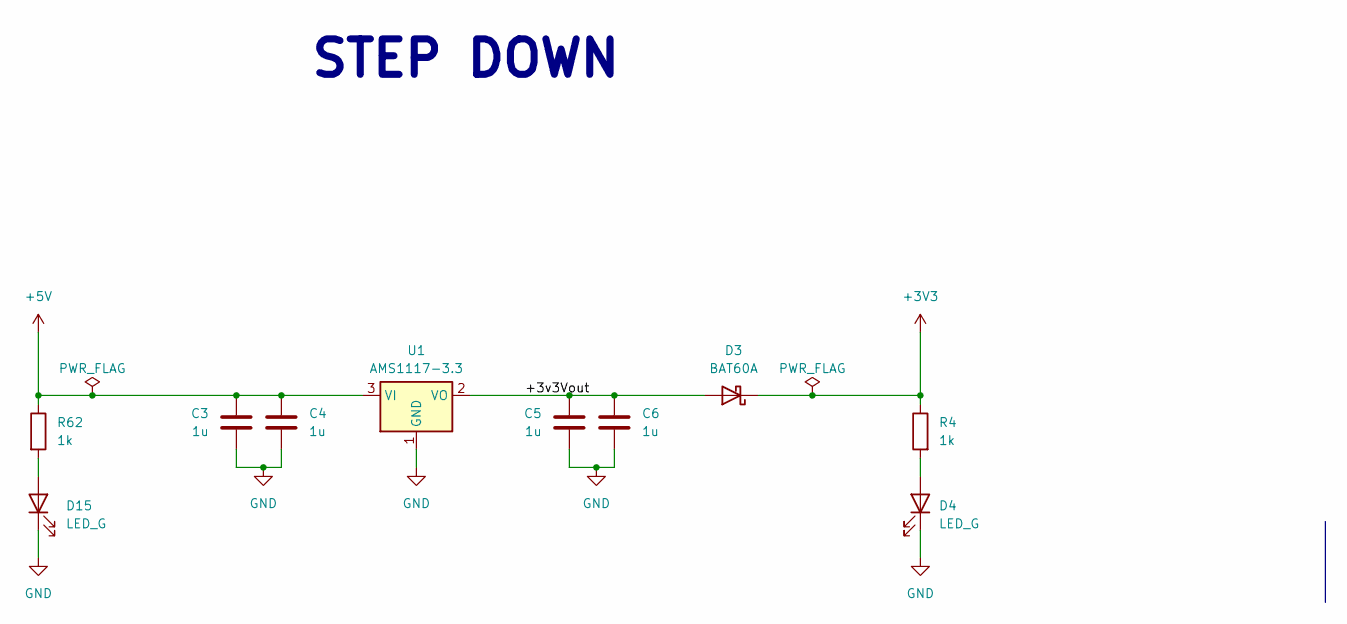
[picture p9: schematic STEP-DOWN.kicad_sch]

Parts:
C3, C4, C5, C6: 1u; C_0603_1608Metric
D3: BAT60A; D_SOD-323
D4, D15: LED_G; LED_1206_3216Metric
R4, R62: 1k; R_0603_1608Metric_Pad0.98x0.95mm_HandSolder
U1: AMS1117-3.3; SOT-223-3_TabPin2

Connections:
+3V3: D3.1 (K), R4.1; also elsewhere on the board
+5V: C3.1, C4.1, R62.1, U1.3 (VI); also elsewhere on the board
/STEP-DOWN/+3v3Vout: C5.1, C6.1, D3.2 (A), U1.2 (VO)
GND: C3.2, C4.2, C5.2, C6.2, D4.1 (K), D15.1 (K), U1.1 (GND); also elsewhere on the board
unnamed: D4.2 (A), R4.2
unnamed: D15.2 (A), R62.2

Notes on the sheet:
STEP DOWN

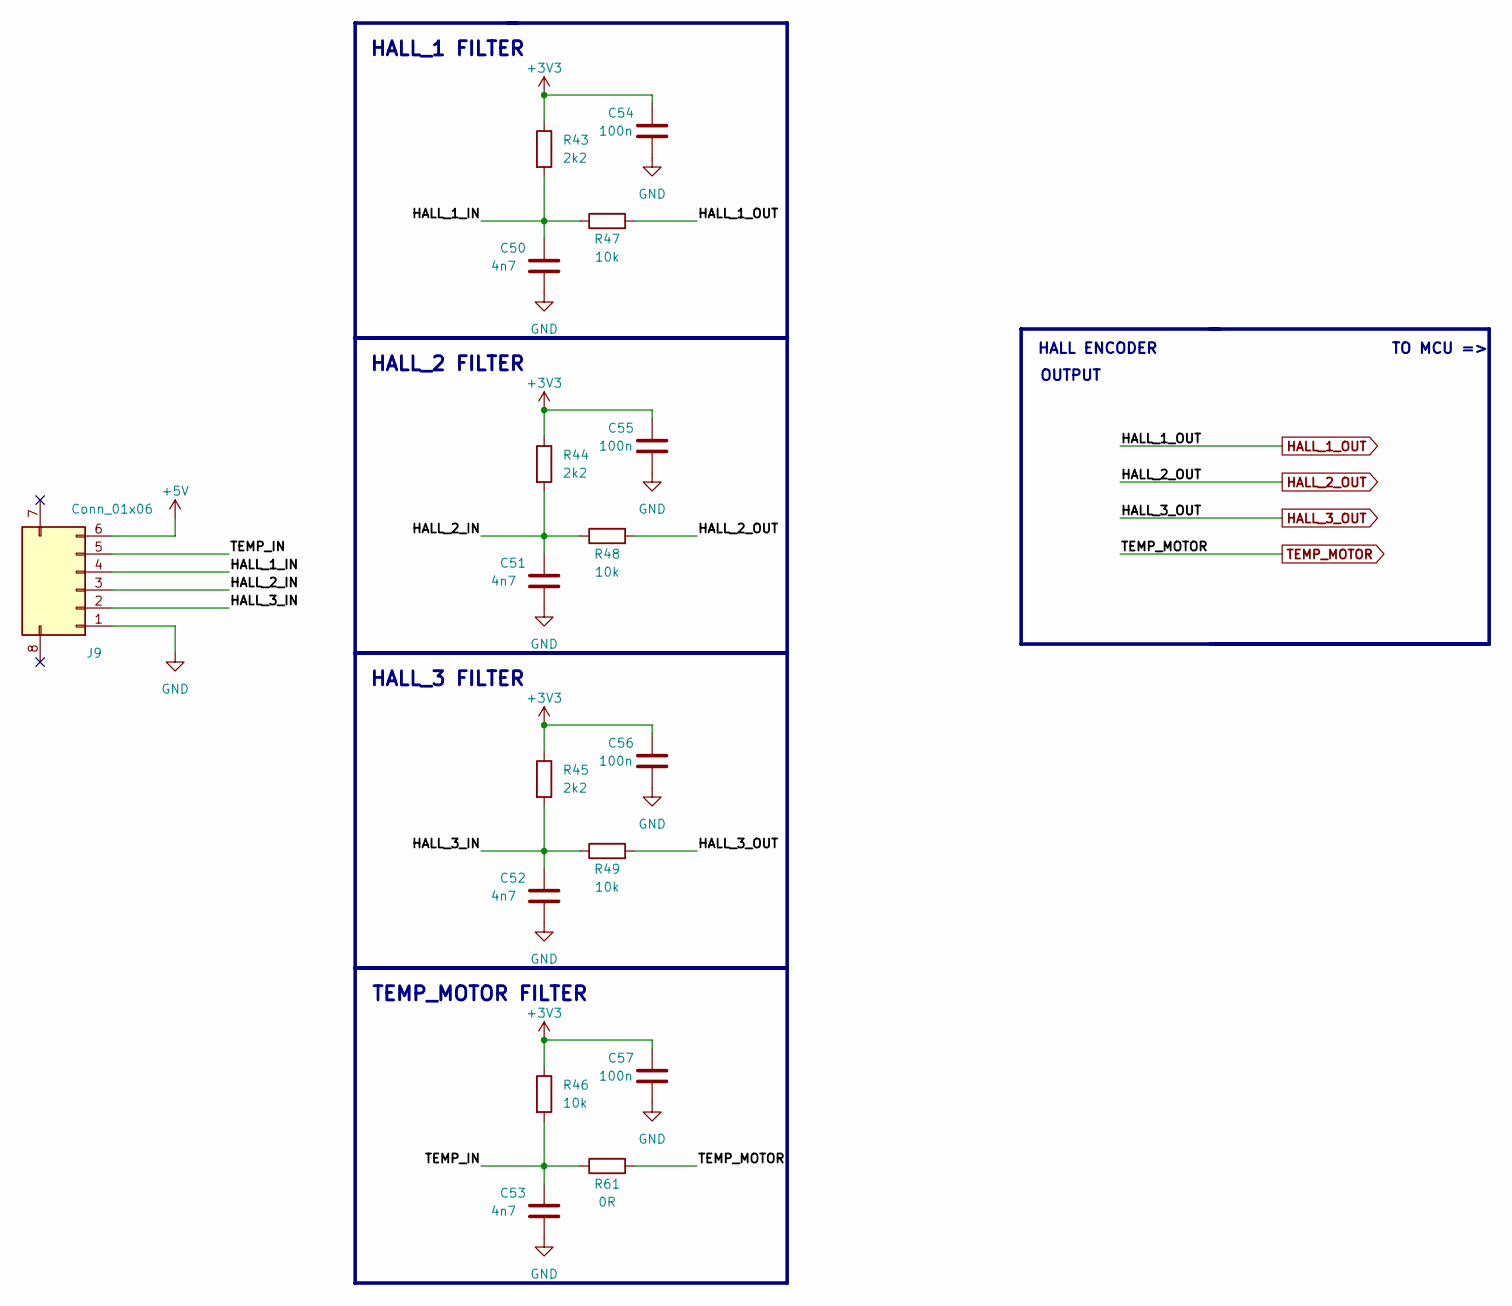
[picture p10: schematic Filters.kicad_sch]

Parts:
C50, C51, C52, C53: 4n7; C_0603_1608Metric
C54, C55, C56, C57: 100n; C_0603_1608Metric
J9: Conn_01x06; CONN-SMD_S6B-XH-SM4-TB-LF-SN
R43, R44, R45: 2k2; R_0603_1608Metric_Pad0.98x0.95mm_HandSolder
R46, R47, R48, R49: 10k; R_0603_1608Metric_Pad0.98x0.95mm_HandSolder
R61: 0R; R_0603_1608Metric_Pad0.98x0.95mm_HandSolder

Connections:
+3V3: C54.1, C55.1, C56.1, C57.1, R43.1, R44.1, R45.1, R46.1; also elsewhere on the board
+5V: J9.6; also elsewhere on the board
/Filters/HALL_1_IN: C50.1, J9.4, R43.2, R47.1
/Filters/HALL_2_IN: C51.1, J9.3, R44.2, R48.1
/Filters/HALL_3_IN: C52.1, J9.2, R45.2, R49.1
/Filters/TEMP_IN: C53.1, J9.5, R46.2, R61.1
GND: C50.2, C51.2, C52.2, C53.2, C54.2, C55.2, C56.2, C57.2, J9.1; also elsewhere on the board
HALL_1_OUT: R47.2; also elsewhere on the board
HALL_2_OUT: R48.2; also elsewhere on the board
HALL_3_OUT: R49.2; also elsewhere on the board
TEMP_MOTOR: R61.2; also elsewhere on the board

Notes on the sheet:
TEMP_MOTOR FILTER
OUTPUT
HALL_3 FILTER
HALL ENCODER TO MCU =>
HALL_2 FILTER
HALL_1 FILTER

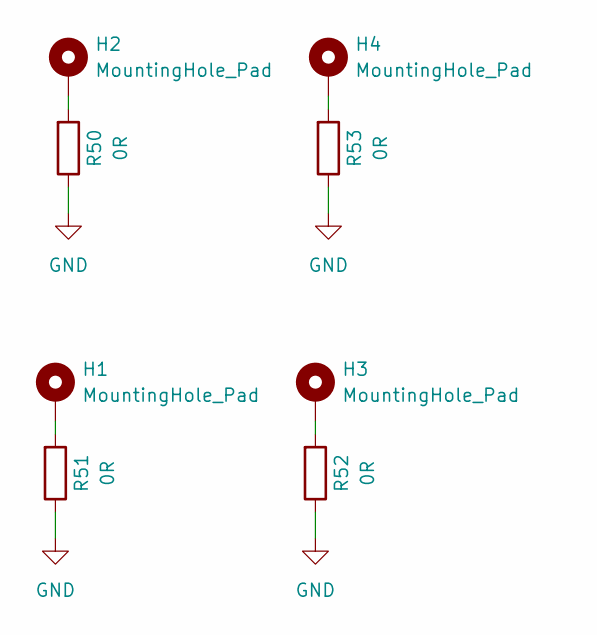
[picture p11: schematic Mechanical.kicad_sch]

Parts:
H1, H2, H3, H4: MountingHole_Pad; MountingHole_3.2mm_M3_Pad_Via
R50, R51, R52, R53: 0R; R_0603_1608Metric_Pad0.98x0.95mm_HandSolder

Connections:
GND: R50.1, R51.1, R52.1, R53.1; also elsewhere on the board
unnamed: H1.1, R51.2
unnamed: H2.1, R50.2
unnamed: H3.1, R52.2
unnamed: H4.1, R53.2
