Will-McKnight-604/BLDC_Motor_Control/Projects/Fresu/BLDC Motor Controller/Design/rev01/rev01_1/BLDC_Motor Controller/BLDC_Motor Controller.kicad_pcb

## KiCad design Projects/Fresu/BLDC Motor Controller/Design/rev01/rev01_1/BLDC_Motor Controller/BLDC_Motor Controller.kicad_pcb (continued)

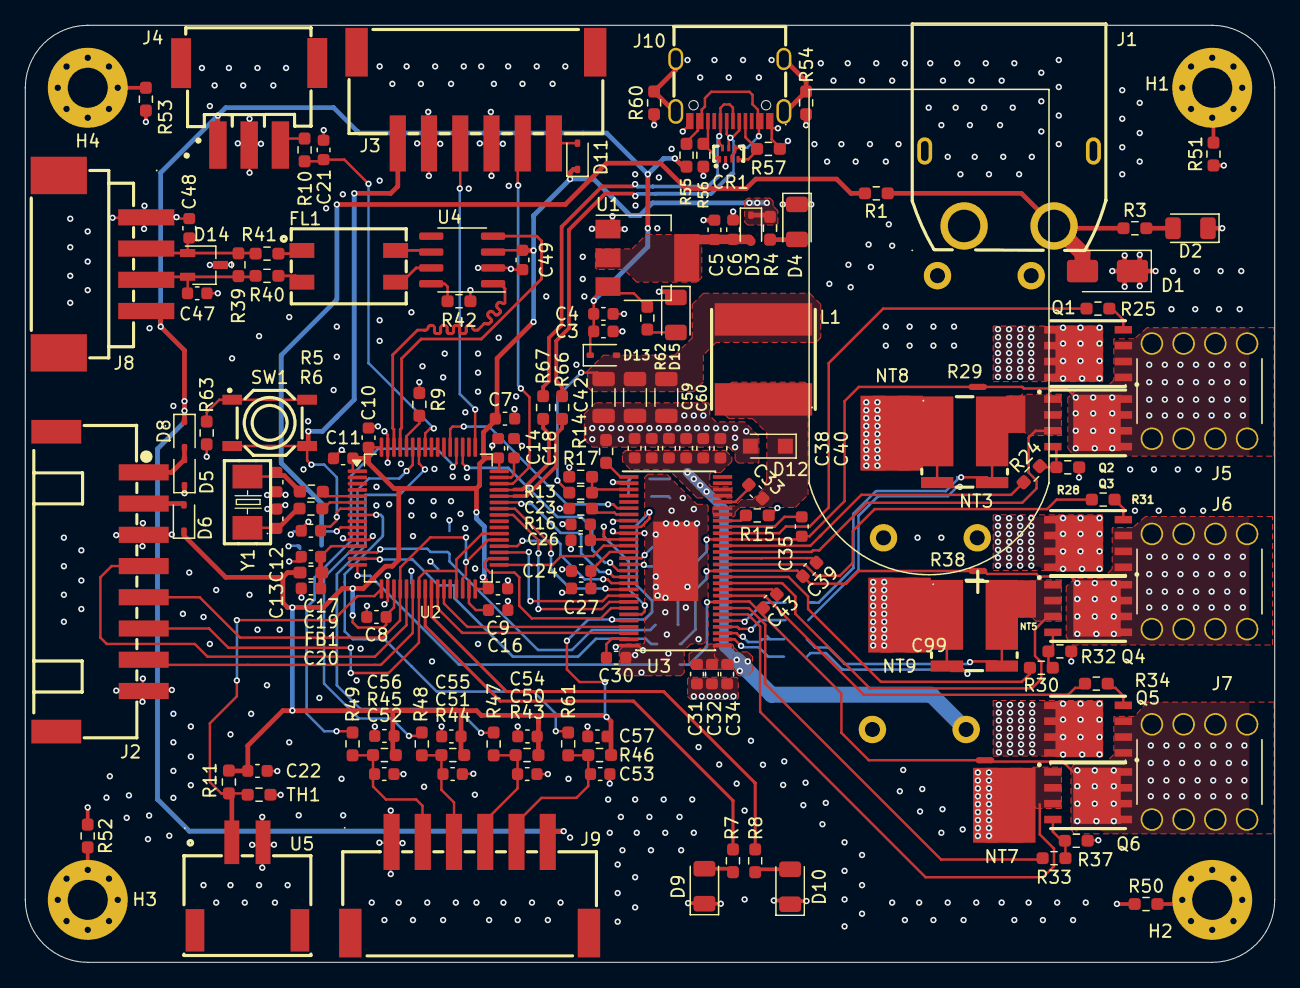
[picture p12: board BLDC_Motor Controller.kicad_pcb from above]

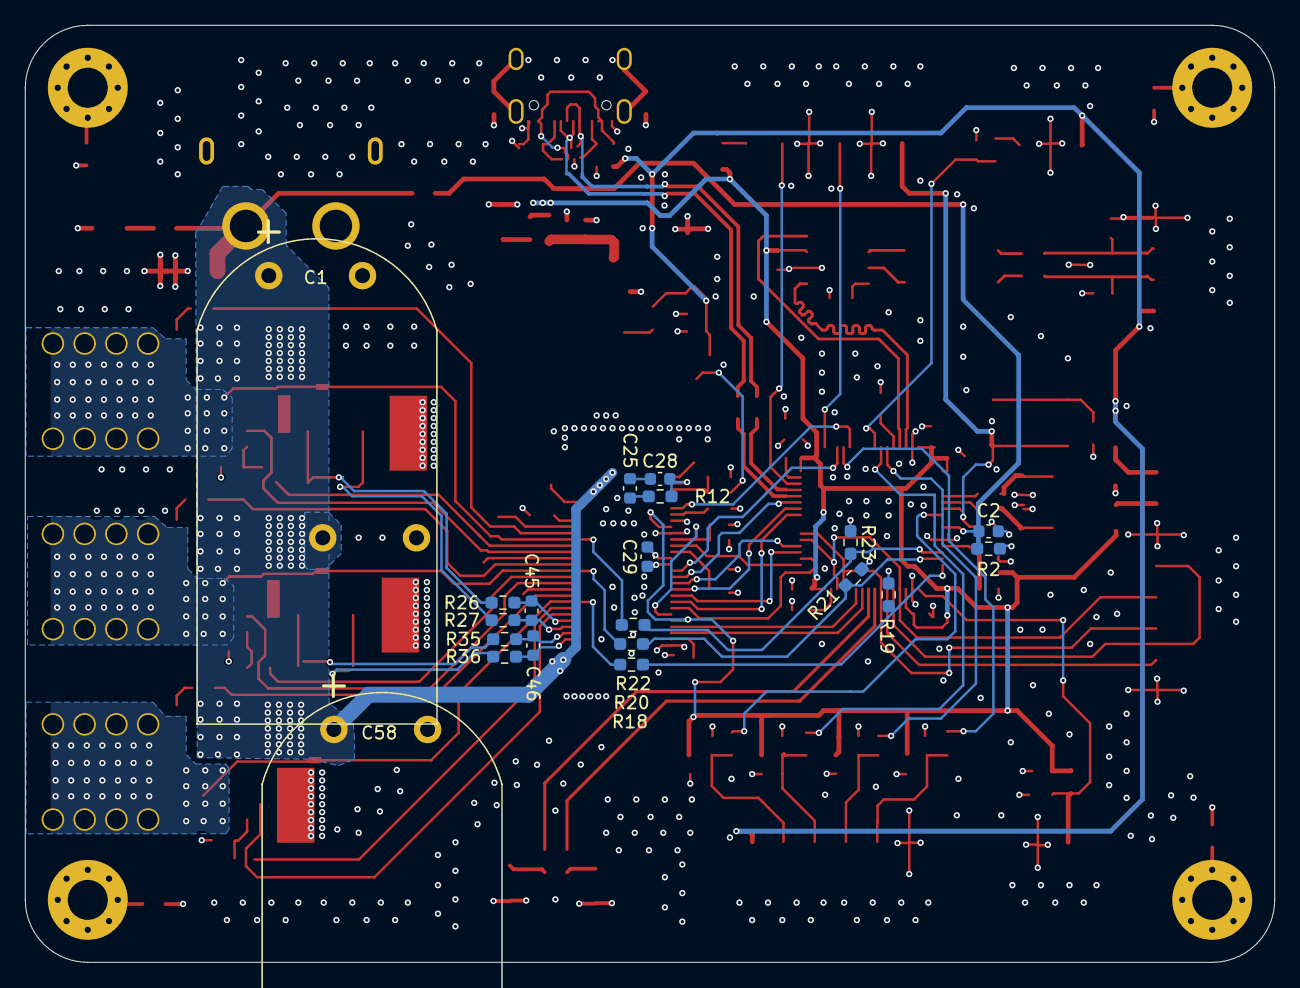
[picture p13: board BLDC_Motor Controller.kicad_pcb from below]

Board: 4 copper layers, 100.0 x 75.0 mm, 178 parts (20 on the bottom side), 126 nets.
