Will-McKnight-604/BLDC_Motor_Control/(commit log)

2024-01-06 Repo Location Change
    Moved Project Files to better organized location
    [Technical-Specification-Template.xlsx]
2024-01-07 Update 2
    Created Project, schematic and pcb templates
    [BLDC_Motor Controller.kicad_pcb, BLDC_Motor Controller.kicad_sch, Will Electronics Templates.kicad_pcb, Will Electronics Templates.kicad_sch]
2024-01-07 Update 3
    Created flat hierarchy and pages, now just need to define them
    [BLDC_Motor Controller.kicad_sch, Block Diagram.kicad_sch, CAN BUS.kicad_sch, FET Driver.kicad_sch, Filters.kicad_sch, MCU.kicad_sch, MOSFETS.kicad_sch, Mechanical.kicad_sch]
2024-01-07 Update 4
    Started Block Diagram page
    [Block Diagram.kicad_sch]
2024-01-09 Update 5
    nearly completed MCU schematic, PDF version is wrong so waiting for it to be fixed
    [MCU.kicad_sch]
2024-01-13 UPDATE 6
    Completed MCU schematic Page
    [MCU.kicad_sch, MOSFETS.kicad_sch]
2024-01-13 UPDATE 7
    COMPLETED MOSFET SCHEMATIC
    [FET Driver.kicad_sch, MOSFETS.kicad_sch]
2024-01-13 UPDATE 8
    COMPLETED CAN SCHEMATIC
    [CAN BUS.kicad_sch]
2024-01-13 UPDATE 9
    COMPLETED FILTERS SCHEMATIC
    [Filters.kicad_sch]
2024-01-13 UPDATE 10
    COMPELTED STEP-DOWN SCHEMATAIC
    [BLDC_Motor Controller.kicad_sch, INPUT PROTECTION.kicad_sch, STEP-DOWN.kicad_sch]
2024-01-13 UPDATE 11
    INPUT PROTECTION SCHEMATIC COMPLETE
    [INPUT PROTECTION.kicad_sch]
2024-02-04 Update 12
    added files, like BOM, 3D step files course uses
    [BOM_DF_ESC_REV01_1.xlsx]
2024-02-11 Update 13
    Added:
    1) USB Schematic
    2) footprints to all parts
    [BLDC_Motor Controller.kicad_sch, CAN BUS.kicad_sch, FET Driver.kicad_sch, Filters.kicad_sch, INPUT PROTECTION.kicad_sch, MCU.kicad_sch, MOSFETS.kicad_sch, STEP-DOWN.kicad_sch]
2024-02-11 Update 14
    Added 4 mounting holes, imported all components into PCB project, created board outline
    [BLDC_Motor Controller.kicad_pcb, MOSFETS.kicad_sch, Mechanical.kicad_sch]
2024-02-11 Update 15
    Fixing some schematic errors
    initial layout of larger component complete
    [BLDC_Motor Controller.kicad_pcb, CAN BUS.kicad_sch, FET Driver.kicad_sch, Filters.kicad_sch, INPUT PROTECTION.kicad_sch, MCU.kicad_sch, MOSFETS.kicad_sch, Mechanical.kicad_sch]
2024-02-12 Update 16
    Almost finished placing all the components on the board as rough placement
    [BLDC_Motor Controller.kicad_pcb, FET Driver.kicad_sch, MCU.kicad_sch, MOSFETS.kicad_sch, USB.kicad_sch]
2024-02-17 Update 17
    Started laying out the driver and the main FET power polygons
    [2024-01-13_18-17-24.SchLib, 2024-01-13_18-25-10.SchLib, 2024-01-13_18-25-12.SchLib, 4xxx.SchLib, 4xxx_IEEE.SchLib, 74xGxx.SchLib, 74xx.SchLib, 74xx_IEEE.SchLib]
2024-02-19 Update 18
    almost done routing driver chip and MCU (first pass)
    [BLDC_Motor Controller.kicad_pcb, BOM_DF_ESC_REV01_1.xlsx, CAN BUS.kicad_sch, MCU.kicad_sch]
2024-02-19 Update 19
    further MCU layout
    [BLDC_Motor Controller.kicad_pcb]
2024-02-19 Update 20
    First layout completed, all tracks laid
    [BLDC_Motor Controller.kicad_pcb, CAN BUS.kicad_sch, MCU.kicad_sch, STEP-DOWN.kicad_sch]
2024-02-19 Update 21
    Now all tracks are laid, working on DRC
    [BLDC_Motor Controller.kicad_pcb]
2024-02-19 Update 22
    Continued DRC
    [BLDC_Motor Controller.kicad_pcb]
2024-02-25 Update 23
    Converted to Kicad 8
    Working on DRC
    [BLDC_Motor Controller.kicad_pcb, BLDC_Motor Controller.kicad_sch, Block Diagram.kicad_sch, CAN BUS.kicad_sch, FET Driver.kicad_sch, Filters.kicad_sch, INPUT PROTECTION.kicad_sch, MCU.kicad_sch]
2024-02-25 Update 24
    DRC Complete
    Generating MFR'ing files
    [BLDC_Motor Controller.kicad_pcb]
2024-03-03 Update 25
    Capturing all updates
    [BLDC_Motor Controller-B_Cu.gbl, BLDC_Motor Controller-B_Mask.gbs, BLDC_Motor Controller-B_Paste.gbp, BLDC_Motor Controller-B_Silkscreen.gbo, BLDC_Motor Controller-Edge_Cuts.gm1, BLDC_Motor Controller-F_Cu.gtl, BLDC_Motor Controller-F_Mask.gts, BLDC_Motor Controller-F_Paste.gtp]
2024-03-03 Update 26
    Matched DF's Designators to mine so I can use BOM as is
    Updated MFR'ing files
    Rev1 Ready for release
    [BLDC_Motor Controller-B_Cu.gbl, BLDC_Motor Controller-B_Mask.gbs, BLDC_Motor Controller-B_Paste.gbp, BLDC_Motor Controller-B_Silkscreen.gbo, BLDC_Motor Controller-Edge_Cuts.gm1, BLDC_Motor Controller-F_Cu.gtl, BLDC_Motor Controller-F_Mask.gts, BLDC_Motor Controller-F_Paste.gtp]
